quistty/6dofarm/README.md

# 6dofarm
Repository for my 6 DOF arm. 
Writeup coming soon
