quistty/6dofarm/Common parts/nema17.SLDASM

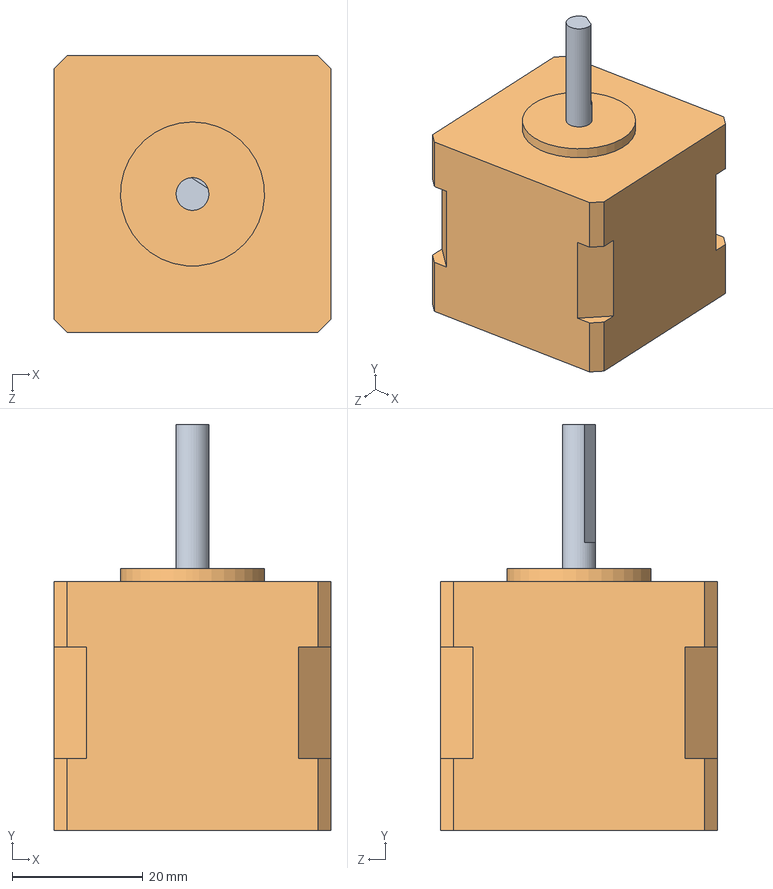
[picture p1: CAD file, 2026-08-21]
Common parts/nema17.SLDASM
42.3 x 62.0 x 42.3 mm
nema17Base
nema17Shaft
