quistty/6dofarm/Final Copy/Joint 4/Joint 4 Assembly.SLDASM

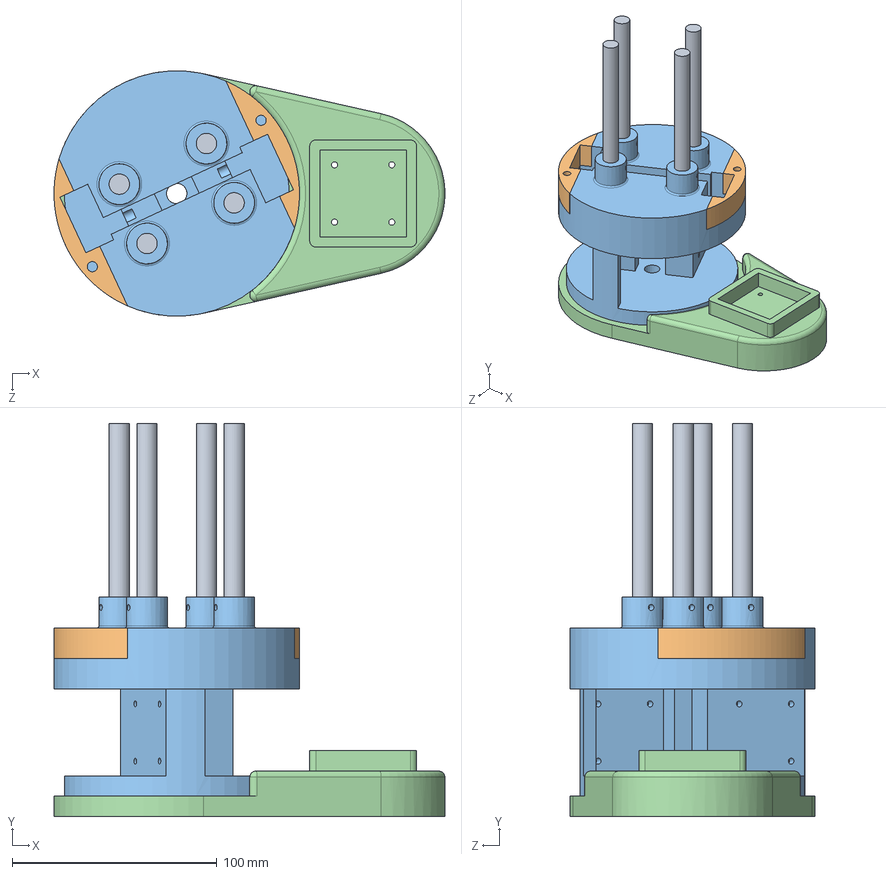
[picture p2: CAD file, 2026-08-21]
Final Copy/Joint 4/Joint 4 Assembly.SLDASM
191.1 x 192.3 x 120.0 mm
J4_Bottom_Motor_Housing
J4_Top_Motor_Housing
J4_Top_Motor_Housing_Bracket
J4_Connnecting_Rod x 4
