quistty/6dofarm/Joint 5-6/joint5and6MainBody.SLDPRT

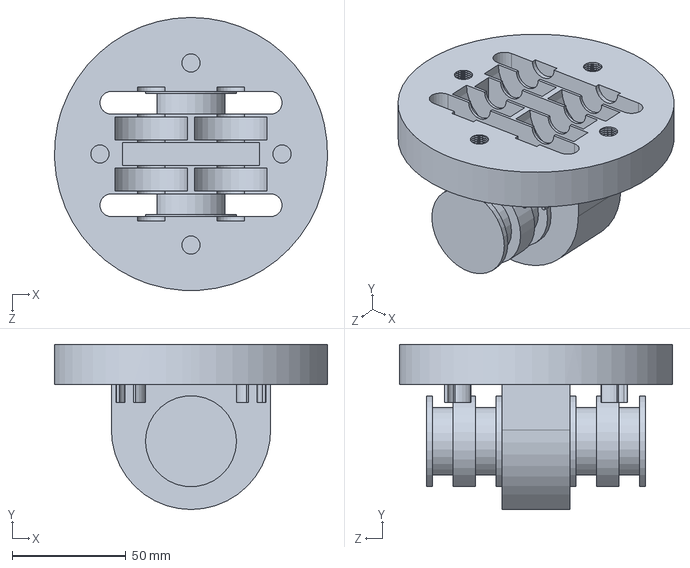
[picture p3: CAD file, 2026-06-25]
Joint 5-6/joint5and6MainBody.SLDPRT
119.9 x 72.5 x 120.0 mm
