quistty/6dofarm/Common parts/Gears/helicalGearCreator.SLDPRT

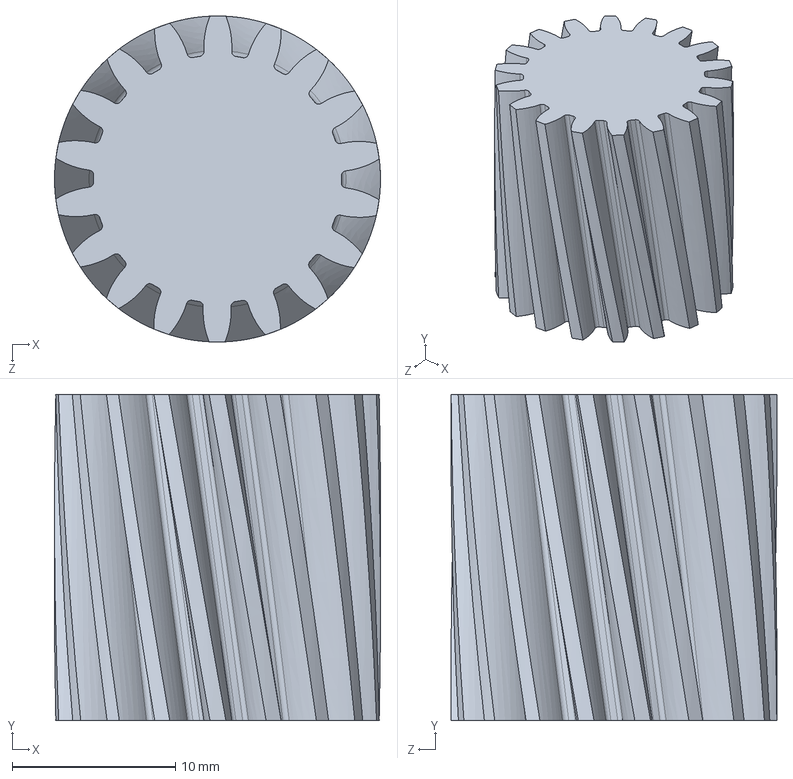
[picture p4: CAD file, 2026-07-15]
Common parts/Gears/helicalGearCreator.SLDPRT
20.0 x 20.0 x 20.0 mm
