quistty/6dofarm/Final Copy/Joint 2/J2_SunGear.SLDPRT

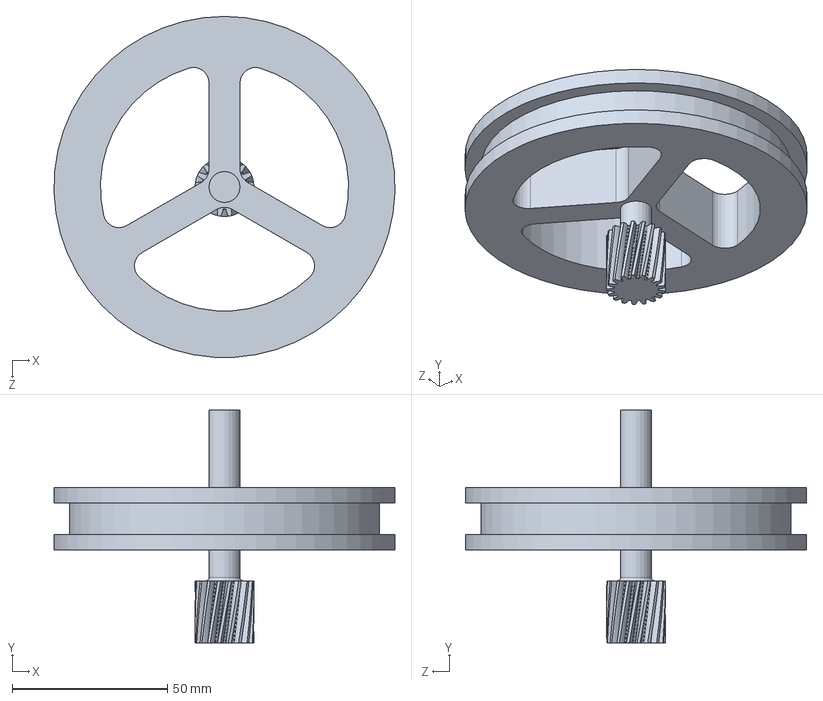
[picture p5: CAD file, 2026-08-21]
Final Copy/Joint 2/J2_SunGear.SLDPRT
109.9 x 75.0 x 110.0 mm
