quistty/6dofarm/Joint 1/BearingHolder.SLDPRT

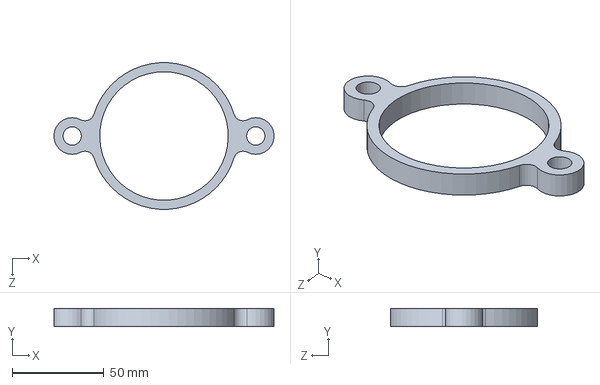
[picture p6: CAD file, 2026-08-21]
Joint 1/BearingHolder.SLDPRT
119.9 x 10.0 x 79.9 mm
