quistty/6dofarm/Joint 5-6/joint5and6BottomCover.SLDPRT

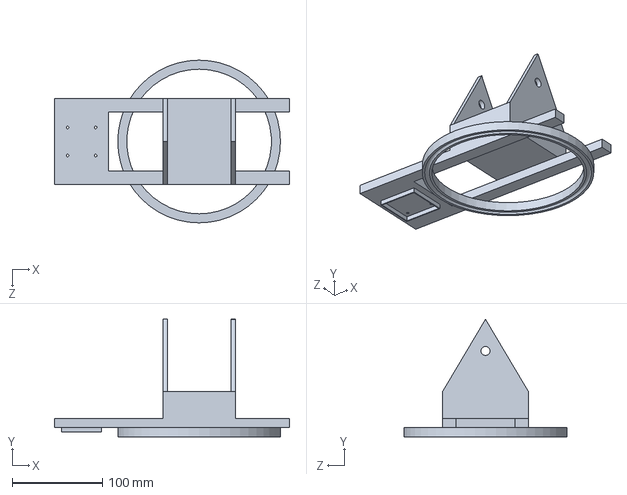
[picture p7: CAD file, 2026-07-15]
Joint 5-6/joint5and6BottomCover.SLDPRT
260.0 x 130.0 x 180.0 mm
