quistty/6dofarm/Prototypes/Part1.SLDPRT

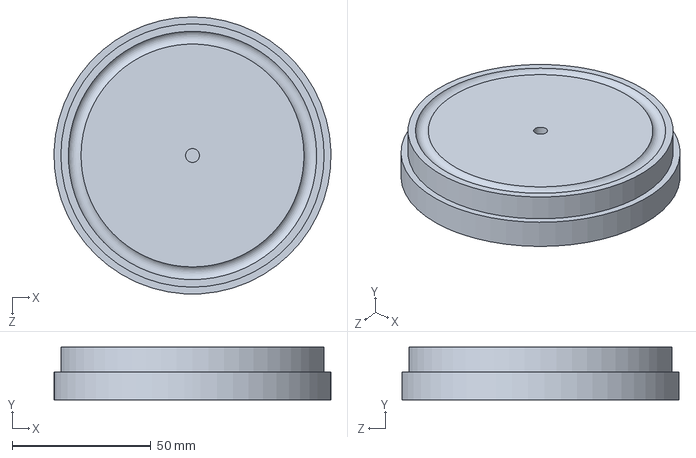
[picture p8: CAD file, 2026-08-05]
Prototypes/Part1.SLDPRT
100.0 x 19.0 x 100.0 mm
