quistty/6dofarm/Prototypes/Tolerances/40mm tolerance hole.SLDPRT

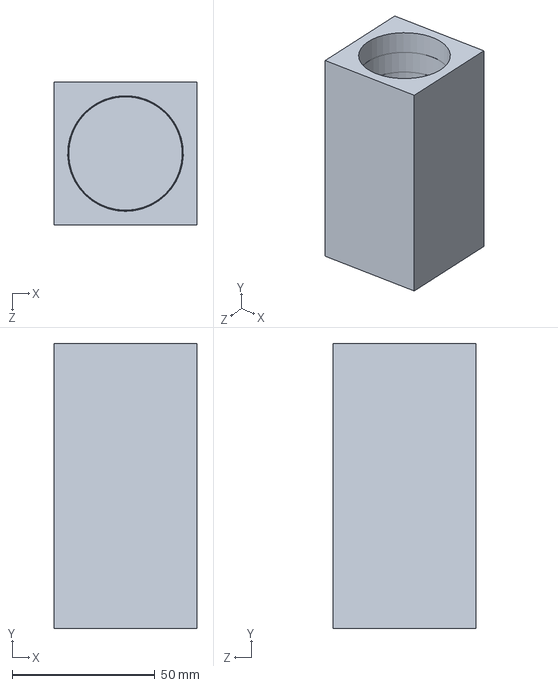
[picture p9: CAD file, 2026-08-18]
Prototypes/Tolerances/40mm tolerance hole.SLDPRT
50.0 x 100.0 x 50.0 mm
