quistty/6dofarm/Common parts/nema17Shaft.SLDPRT

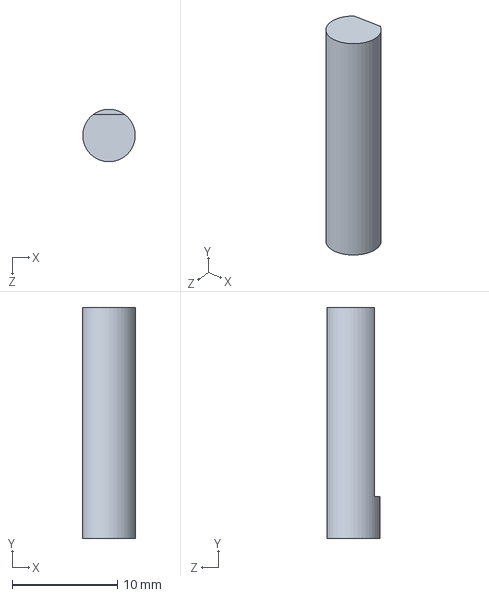
[picture p10: CAD file, 2026-08-13]
Common parts/nema17Shaft.SLDPRT
5.00 x 22.0 x 5.00 mm
