quistty/6dofarm/Final Copy/Joint 1/J1_helicalHousing.SLDPRT

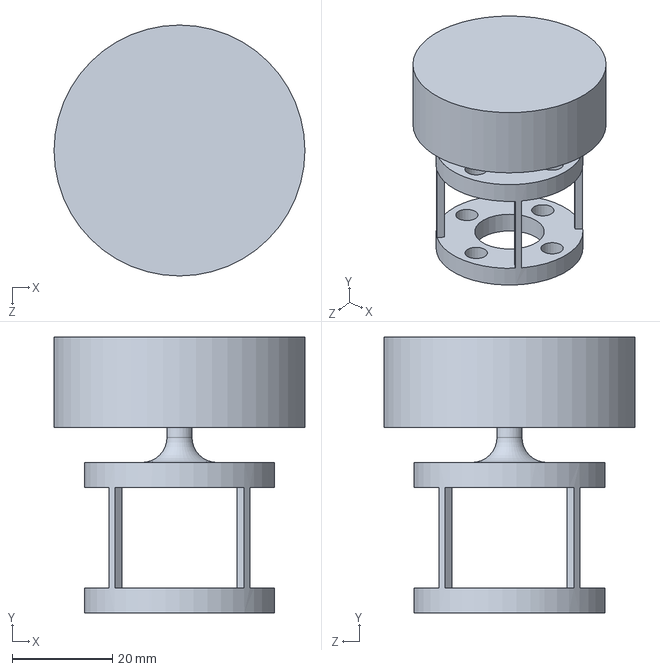
[picture p11: CAD file, 2026-08-21]
Final Copy/Joint 1/J1_helicalHousing.SLDPRT
50.0 x 55.0 x 50.0 mm
