quistty/6dofarm/Final Copy/Joint 4/J4_Bottom_Motor_Housing.SLDPRT

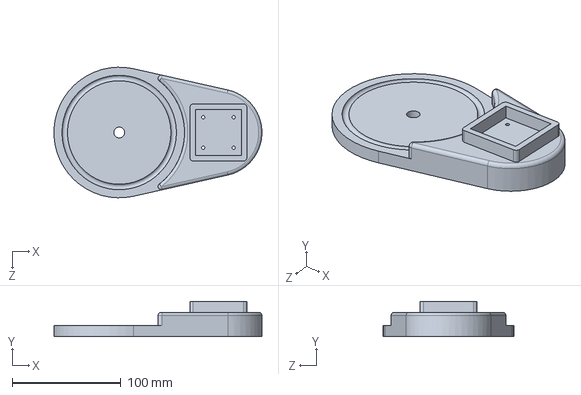
[picture p12: CAD file, 2026-08-13]
Final Copy/Joint 4/J4_Bottom_Motor_Housing.SLDPRT
191.0 x 32.3 x 120.0 mm
