quistty/6dofarm/Joint 1/Joint1Housing.SLDPRT

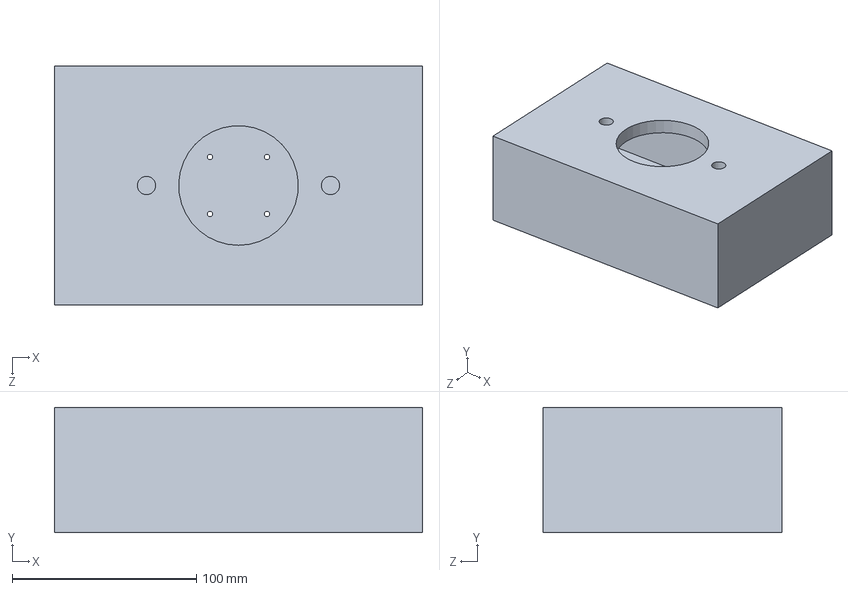
[picture p14: CAD file, 2026-08-21]
Joint 1/Joint1Housing.SLDPRT
200.0 x 68.0 x 130.0 mm
