quistty/6dofarm/Joint 2/Joint2RodHolder.SLDPRT

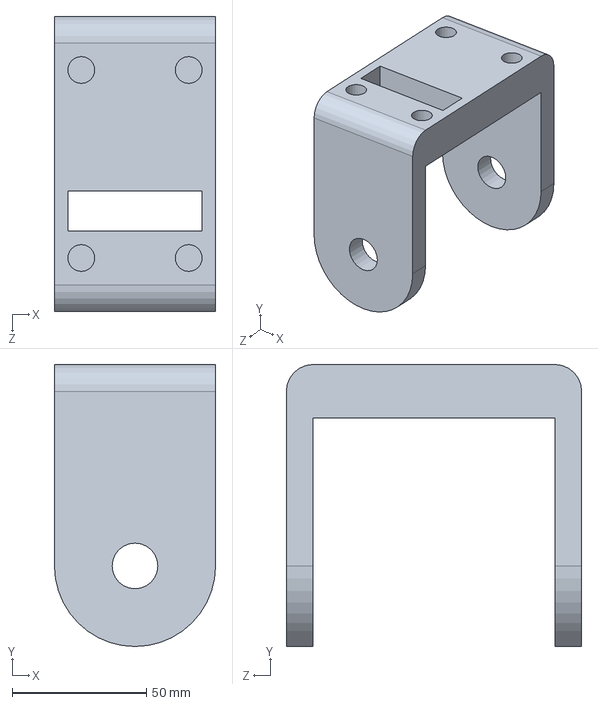
[picture p15: CAD file, 2026-08-21]
Joint 2/Joint2RodHolder.SLDPRT
60.0 x 105.0 x 110.0 mm
