quistty/6dofarm/Joint 3/HousingHelical.SLDPRT

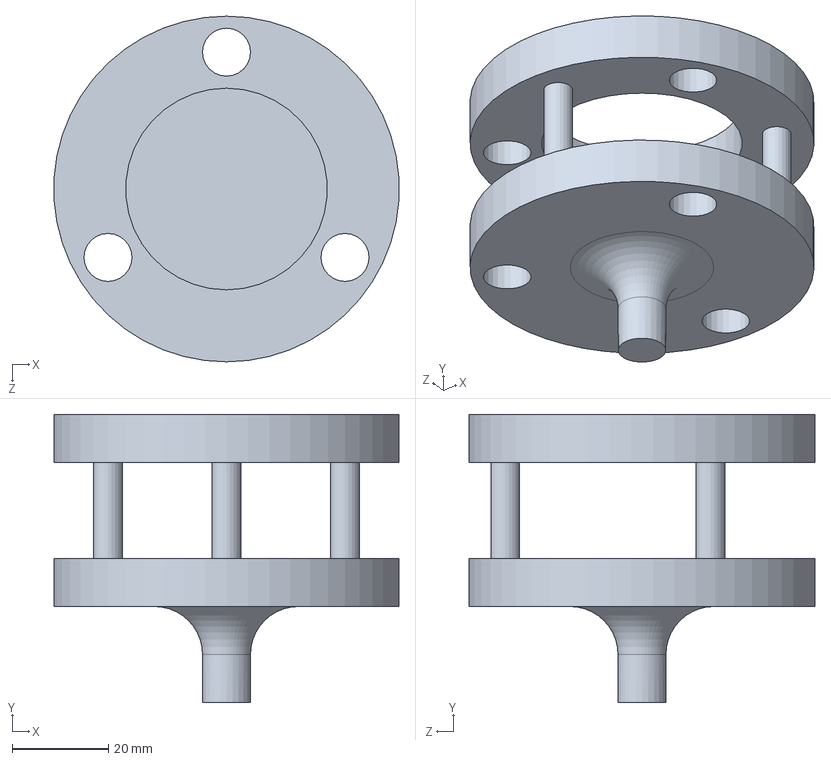
[picture p16: CAD file, 2026-07-15]
Joint 3/HousingHelical.SLDPRT
71.9 x 60.0 x 72.0 mm
