quistty/6dofarm/Prototypes/Tolerances/40mm nominal shaft.SLDPRT

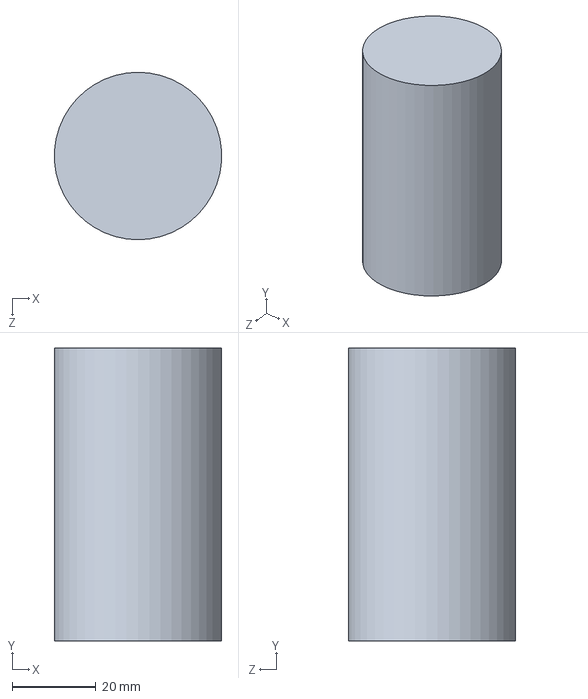
[picture p17: CAD file, 2026-08-18]
Prototypes/Tolerances/40mm nominal shaft.SLDPRT
39.9 x 70.0 x 40.0 mm
