quistty/6dofarm/Rough Assembly Parts/j2.SLDPRT

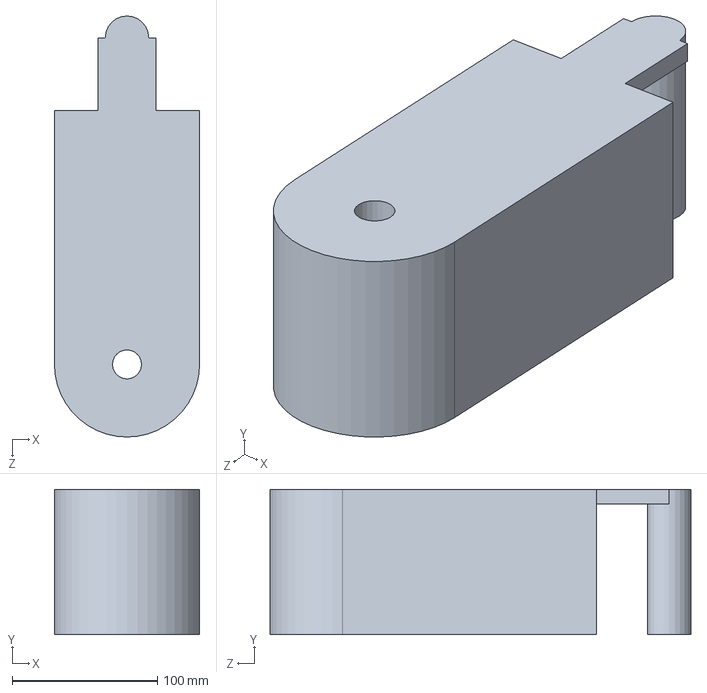
[picture p18: CAD file, 2026-06-13]
Rough Assembly Parts/j2.SLDPRT
100.0 x 100.0 x 290.0 mm
