quistty/6dofarm/Common parts/Gears/Gear1.SLDPRT

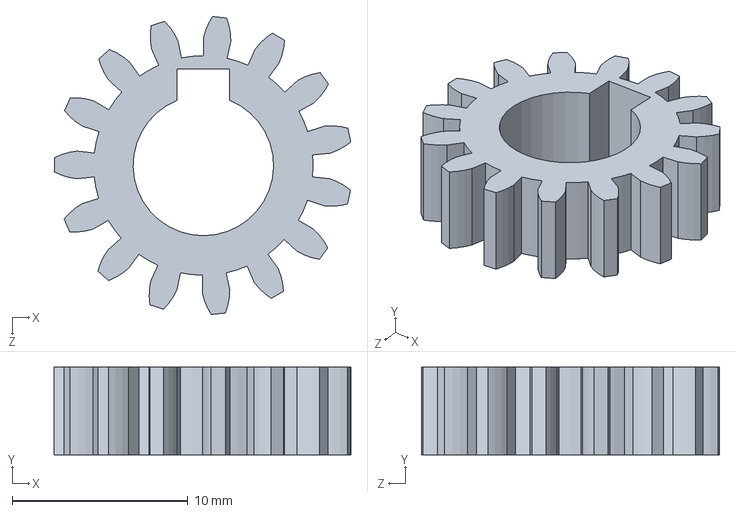
[picture p19: CAD file, 2026-07-01]
Common parts/Gears/Gear1.SLDPRT
16.9 x 5.00 x 17.0 mm
