quistty/6dofarm/Common parts/nema17Base.SLDPRT

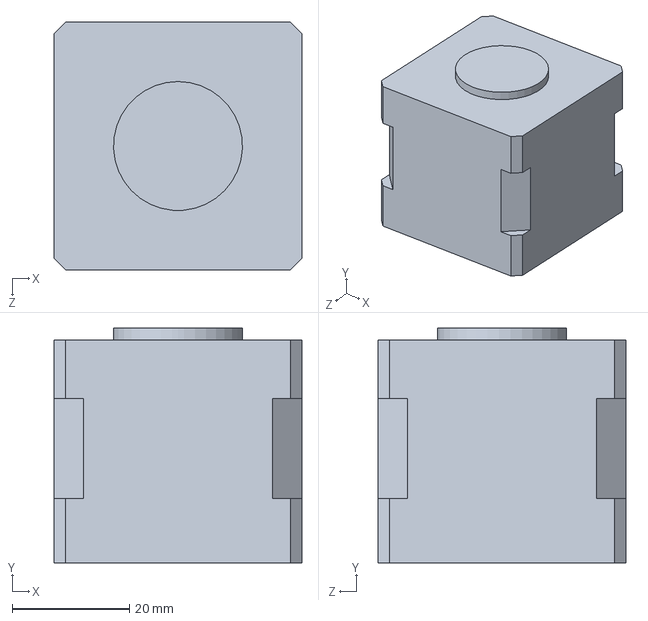
[picture p20: CAD file, 2026-08-13]
Common parts/nema17Base.SLDPRT
42.3 x 40.0 x 42.3 mm
