quistty/6dofarm/Final Copy/Joint 3/J3_Motor_Holder.SLDPRT

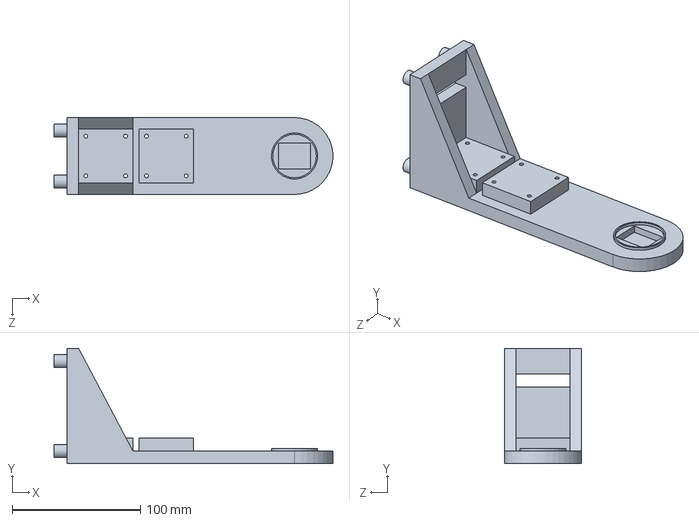
[picture p21: CAD file, 2026-08-21]
Final Copy/Joint 3/J3_Motor_Holder.SLDPRT
217.6 x 90.0 x 60.0 mm
