quistty/6dofarm/Final Copy/Joint 4/J4_Top_Motor_Housing.SLDPRT

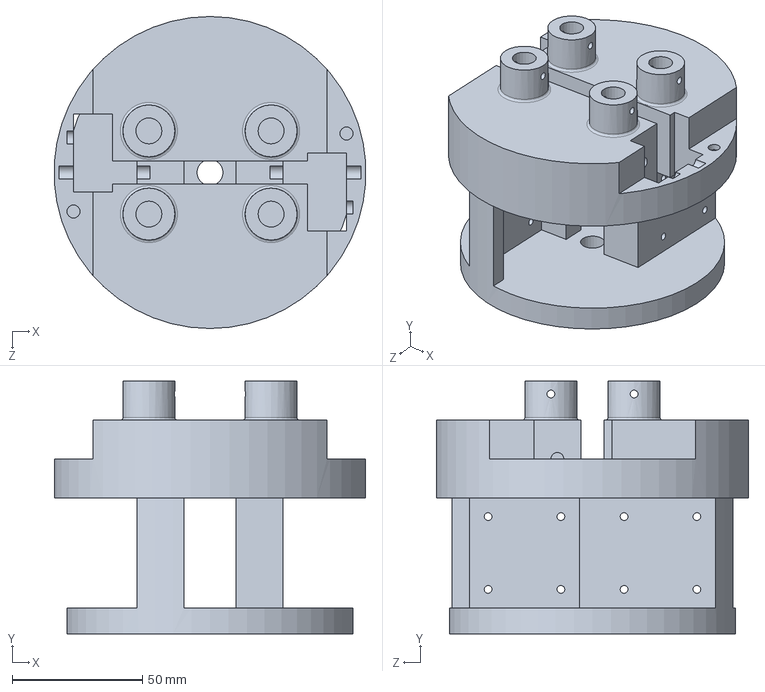
[picture p22: CAD file, 2026-08-12]
Final Copy/Joint 4/J4_Top_Motor_Housing.SLDPRT
119.8 x 97.3 x 120.0 mm
