quistty/6dofarm/Final Copy/Joint 5 and 6/J5-6_Dowel_Holder.SLDPRT

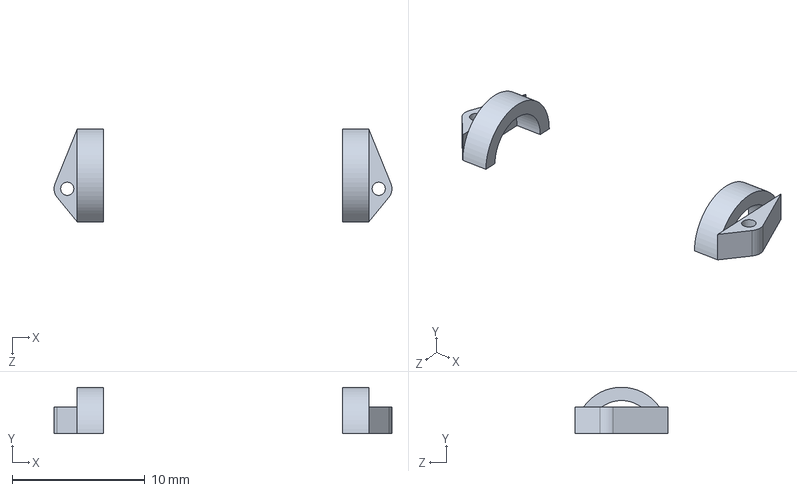
[picture p23: CAD file, 2026-08-13]
Final Copy/Joint 5 and 6/J5-6_Dowel_Holder.SLDPRT
25.5 x 3.50 x 7.00 mm
