quistty/6dofarm/Joint 2/GearRing.SLDPRT

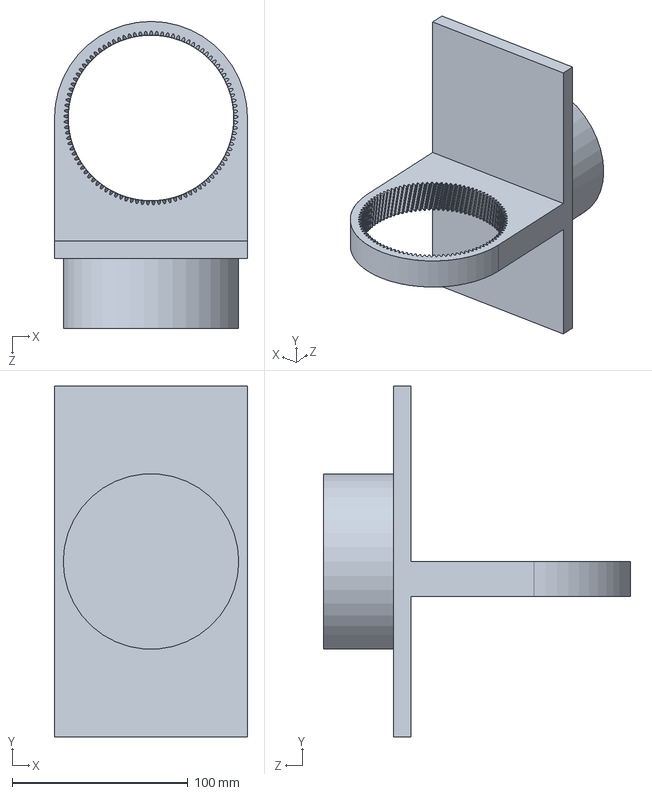
[picture p24: CAD file, 2026-07-15]
Joint 2/GearRing.SLDPRT
110.0 x 200.0 x 175.0 mm
