quistty/6dofarm/Joint 3/helicalSun2.3MF

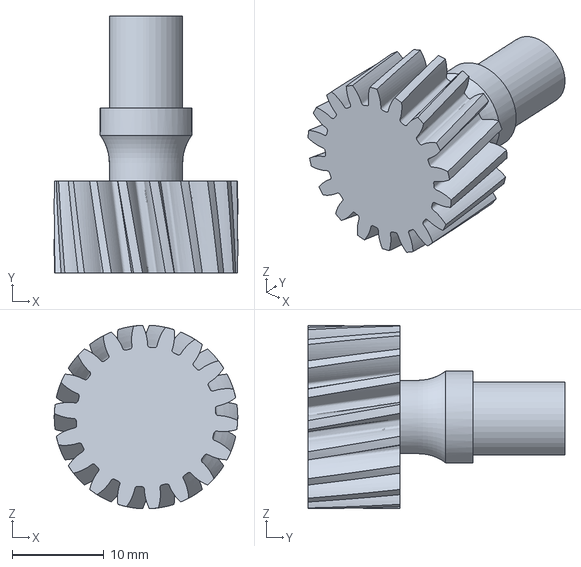
[picture p25: CAD file, 2026-07-13]
Joint 3/helicalSun2.3MF
20.0 x 28.0 x 20.0 mm
