quistty/6dofarm/Prototypes/Part5.SLDPRT

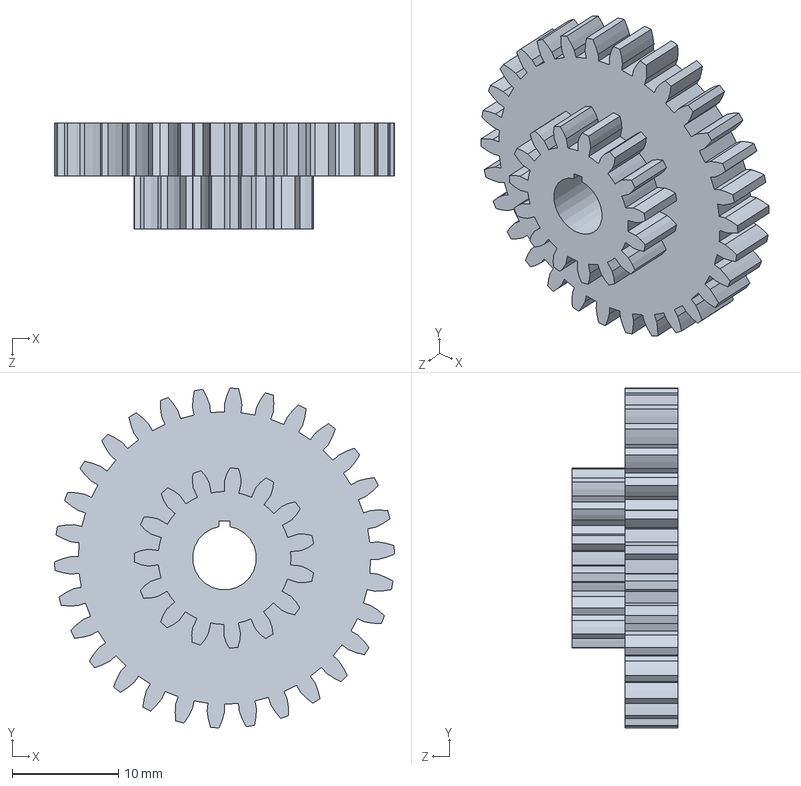
[picture p26: CAD file, 2026-07-13]
Prototypes/Part5.SLDPRT
32.0 x 32.0 x 10.0 mm
