quistty/6dofarm/Rough Assembly Parts/j6.SLDPRT

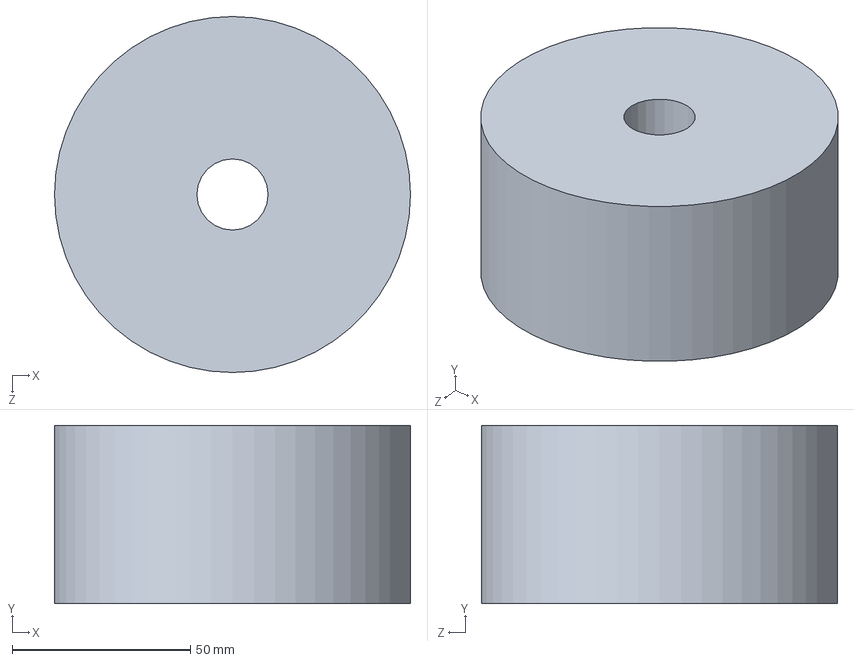
[picture p27: CAD file, 2026-06-13]
Rough Assembly Parts/j6.SLDPRT
100.0 x 50.0 x 100.0 mm
