quistty/6dofarm/Final Copy/Joint 1/J1_Motor_Housing.SLDPRT

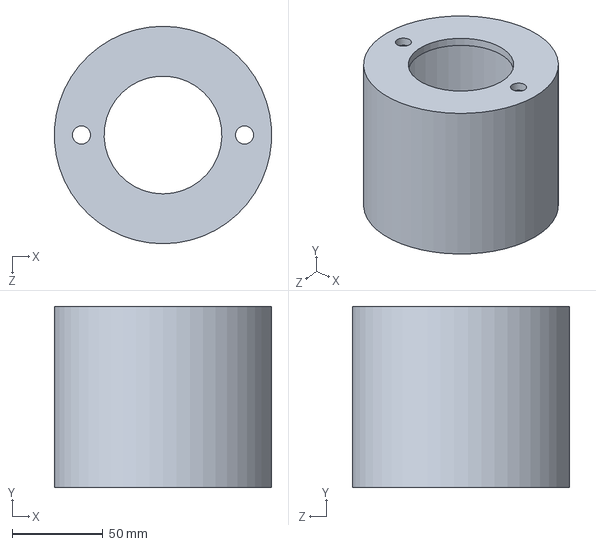
[picture p28: CAD file, 2026-08-21]
Final Copy/Joint 1/J1_Motor_Housing.SLDPRT
119.8 x 100.0 x 120.0 mm
