quistty/6dofarm/Final Copy/Joint 2/J2_Joint2RodHolder.SLDPRT

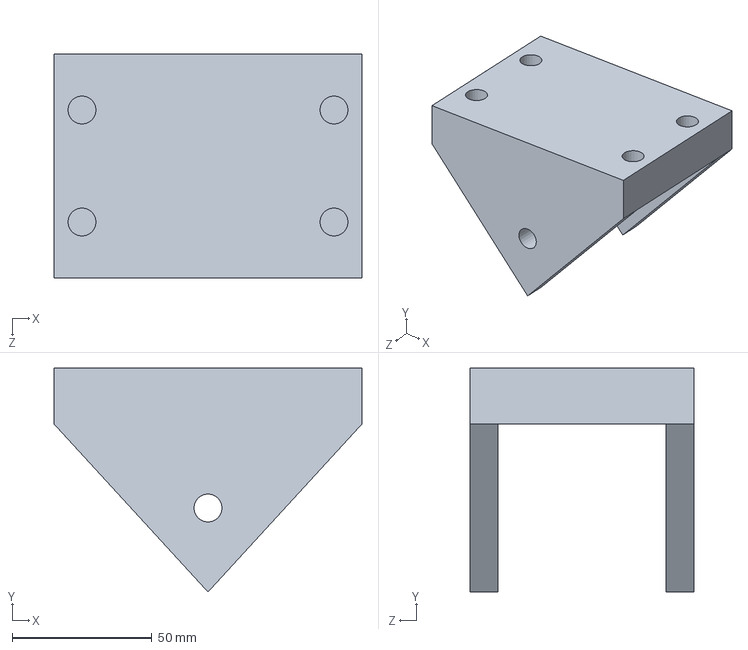
[picture p29: CAD file, 2026-08-21]
Final Copy/Joint 2/J2_Joint2RodHolder.SLDPRT
110.0 x 80.0 x 80.0 mm
