quistty/6dofarm/Final Copy/Joint 3/J3_Motor_Shaft_Key.SLDPRT

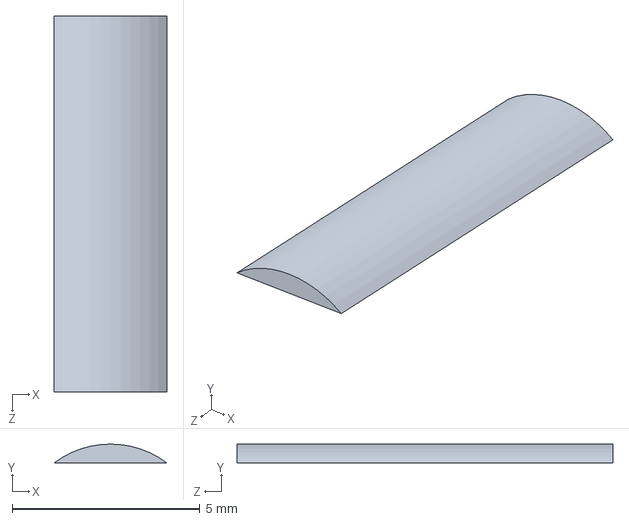
[picture p30: CAD file, 2026-08-13]
Final Copy/Joint 3/J3_Motor_Shaft_Key.SLDPRT
3.00 x 0.5 x 10.0 mm
