quistty/6dofarm/Final Copy/Joint 4/J4_Top_Motor_Housing_Bracket.SLDPRT

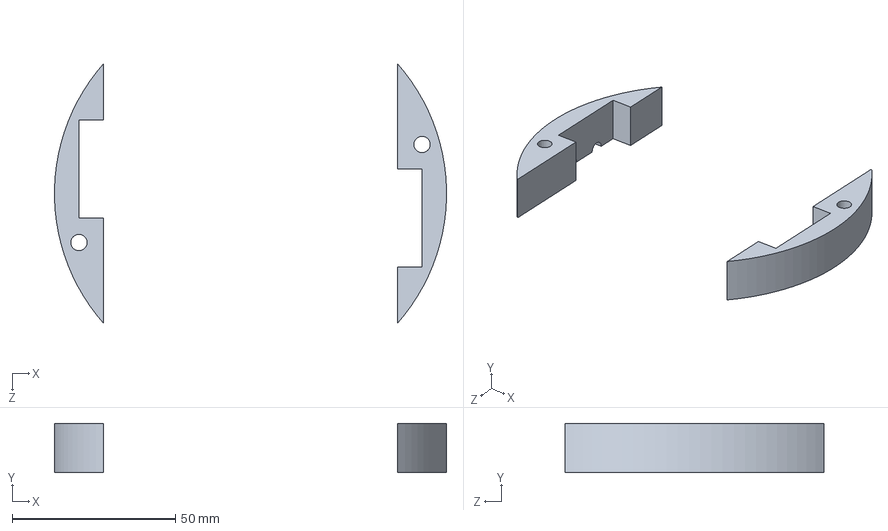
[picture p31: CAD file, 2026-08-11]
Final Copy/Joint 4/J4_Top_Motor_Housing_Bracket.SLDPRT
119.9 x 15.0 x 79.4 mm
