quistty/6dofarm/Final Copy/Joint 5 and 6/J5-6_Bottom_Flange.SLDPRT

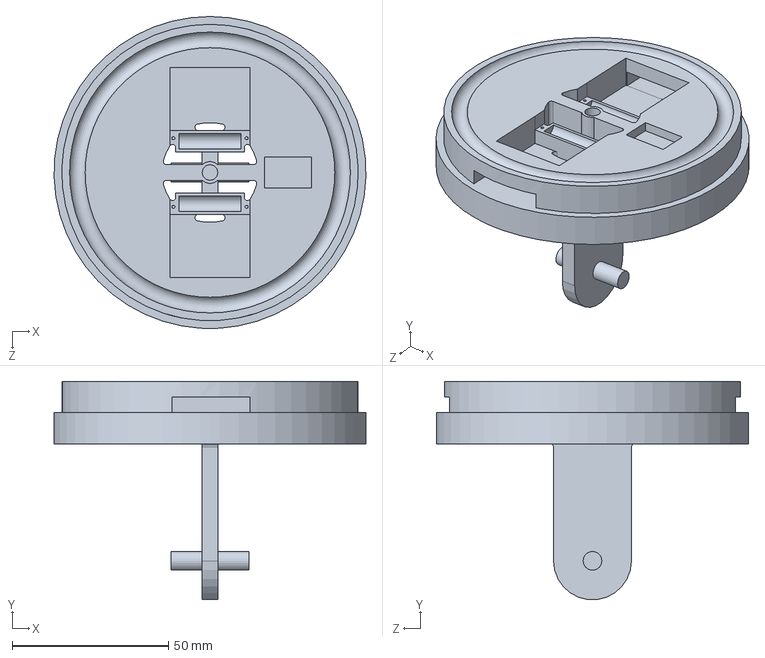
[picture p32: CAD file, 2026-08-13]
Final Copy/Joint 5 and 6/J5-6_Bottom_Flange.SLDPRT
100.0 x 69.9 x 100.0 mm
