quistty/6dofarm/Joint 2/SunGear.SLDPRT

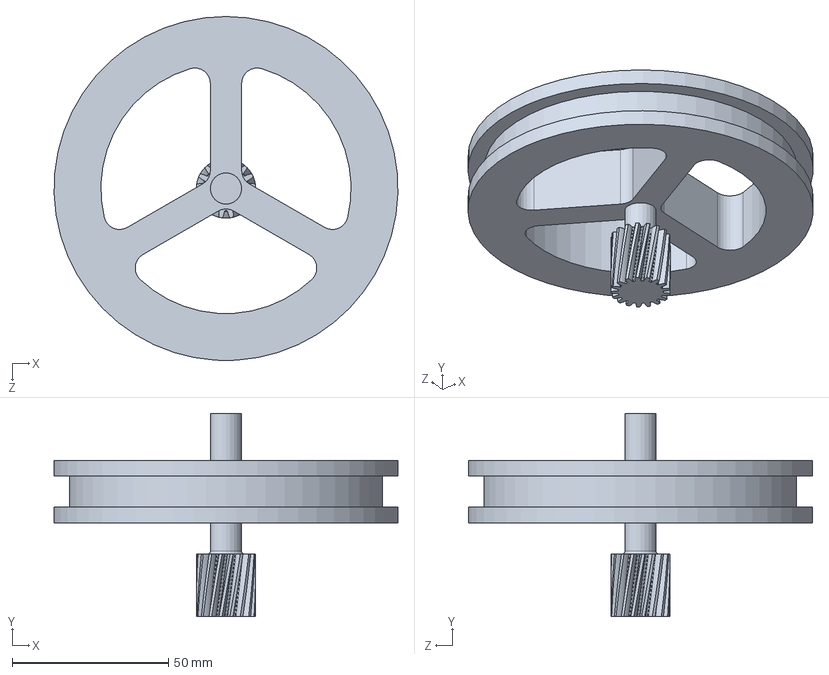
[picture p33: CAD file, 2026-07-15]
Joint 2/SunGear.SLDPRT
109.9 x 65.0 x 110.0 mm
