quistty/6dofarm/Joint 5-6/gearBottomCover.SLDPRT

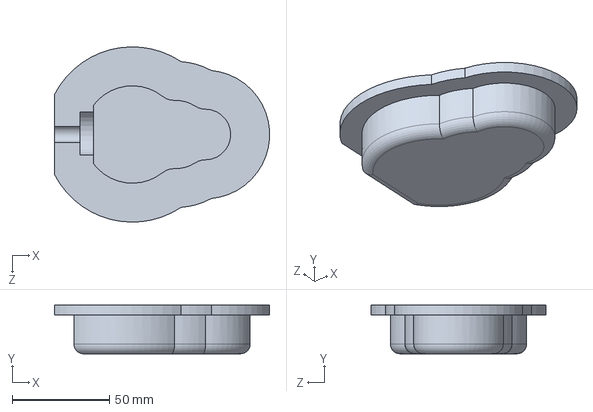
[picture p34: CAD file, 2026-07-13]
Joint 5-6/gearBottomCover.SLDPRT
110.4 x 25.0 x 90.0 mm
