quistty/6dofarm/Prototypes/Spiral Bevel gear Z1.3mf

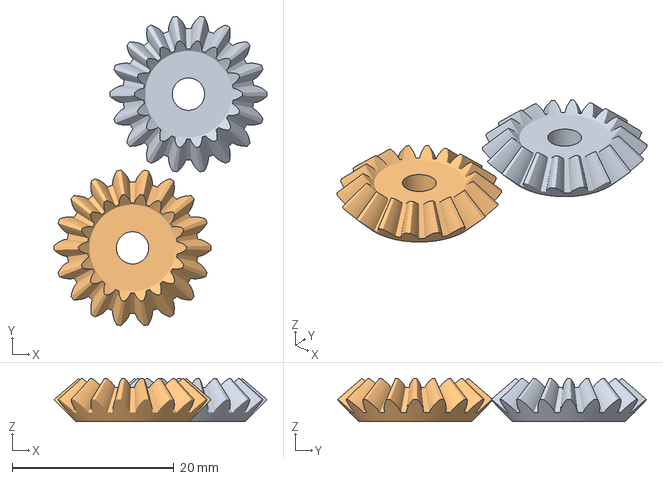
[picture p35: CAD file, 2026-07-01]
Prototypes/Spiral Bevel gear Z1.3mf
26.3 x 38.2 x 5.31 mm
Spiral Bevel gear Z1 x 2
