quistty/6dofarm/Rough Assembly Parts/j5.SLDPRT

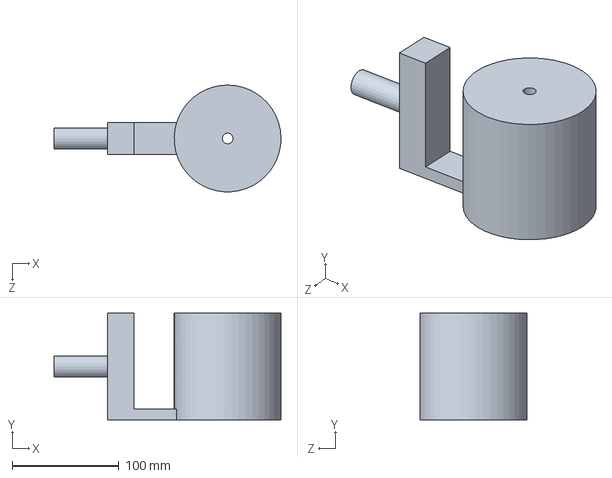
[picture p36: CAD file, 2026-06-13]
Rough Assembly Parts/j5.SLDPRT
212.5 x 100.0 x 100.0 mm
