quistty/6dofarm/Common parts/Gears/gearLocker.SLDPRT

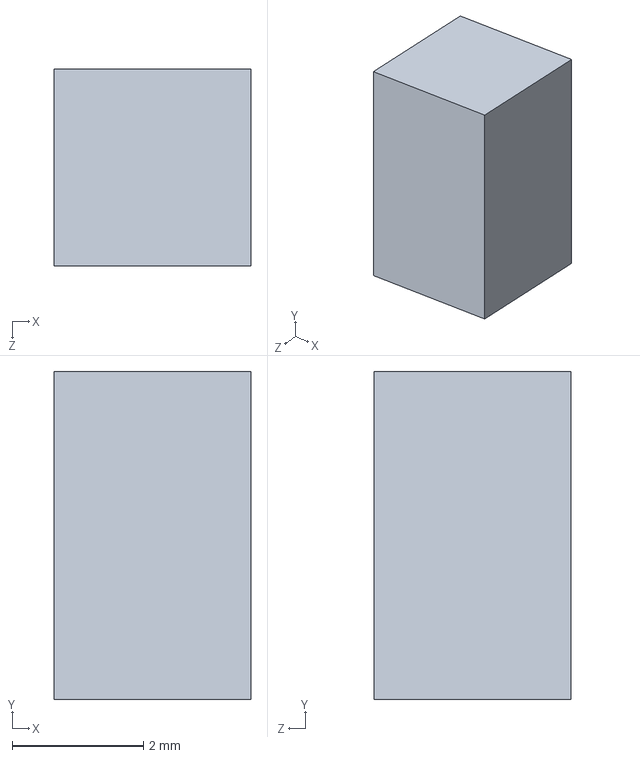
[picture p37: CAD file, 2026-07-01]
Common parts/Gears/gearLocker.SLDPRT
3.00 x 5.00 x 3.00 mm
