quistty/6dofarm/Final Copy/Joint 2/J2_HousingHelical.SLDPRT

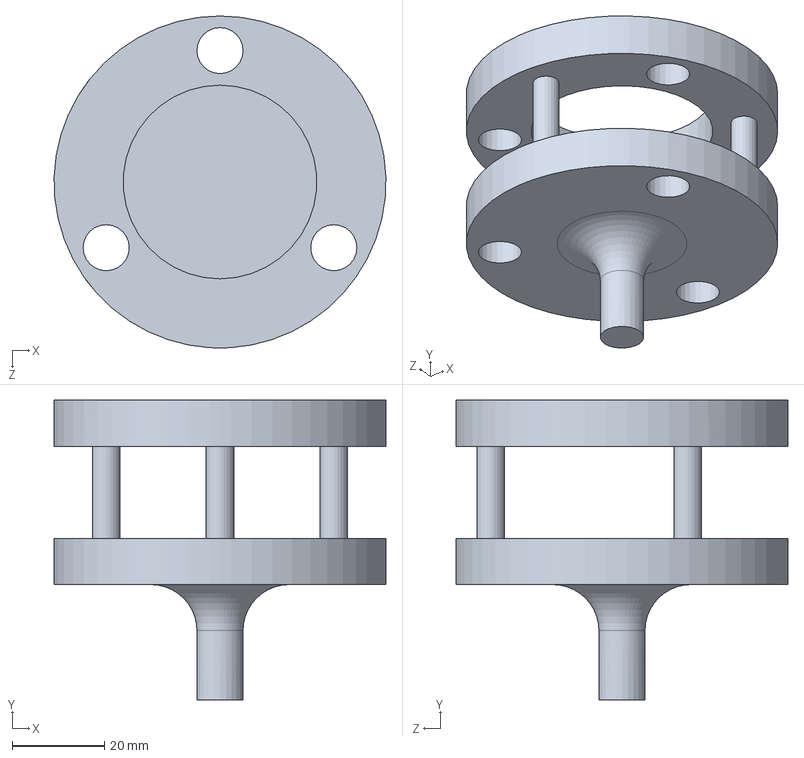
[picture p38: CAD file, 2026-08-21]
Final Copy/Joint 2/J2_HousingHelical.SLDPRT
72.0 x 65.0 x 72.0 mm
