quistty/6dofarm/Final Copy/Joint 3/J3_helicalSun.SLDPRT

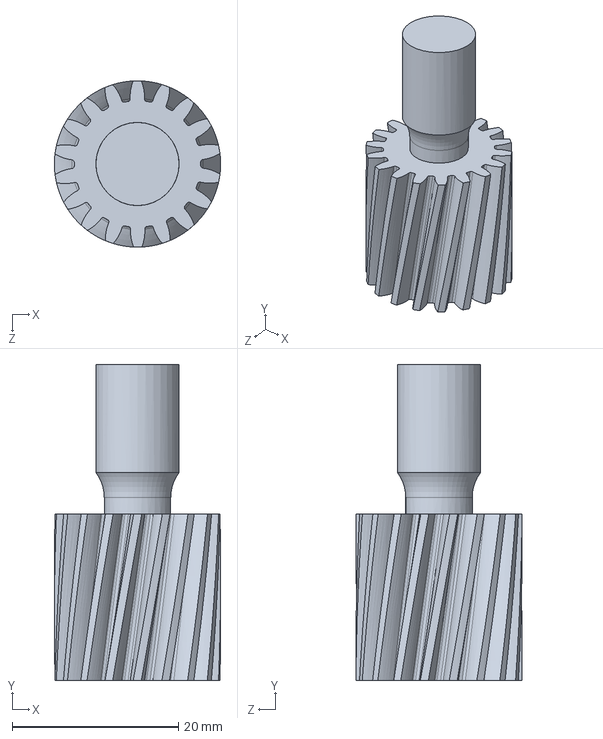
[picture p39: CAD file, 2026-08-13]
Final Copy/Joint 3/J3_helicalSun.SLDPRT
20.0 x 38.0 x 20.0 mm
