quistty/6dofarm/Final Copy/Joint 4/J4_Connnecting_Rod.SLDPRT

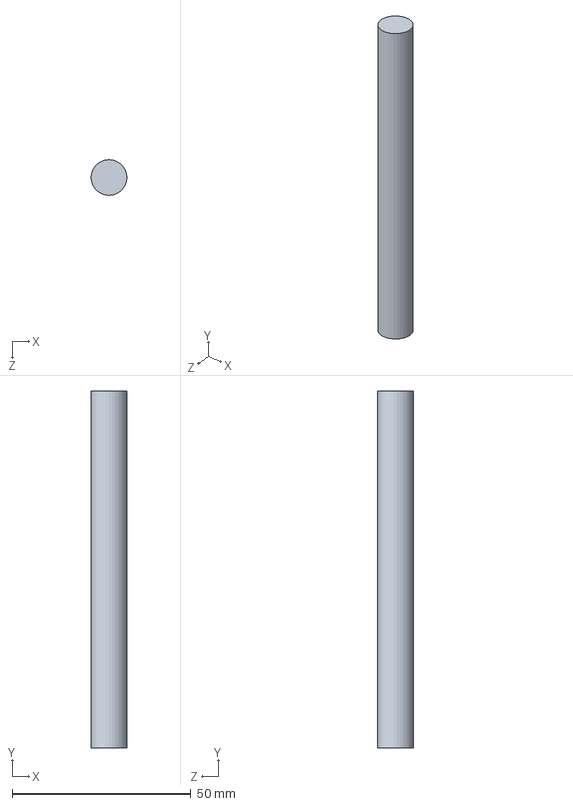
[picture p40: CAD file, 2026-08-08]
Final Copy/Joint 4/J4_Connnecting_Rod.SLDPRT
9.96 x 100.0 x 10.0 mm
