quistty/6dofarm/Final Copy/Joint 5 and 6/J5-6_Bottom_Flange_Inner_Belt_Holder.SLDPRT

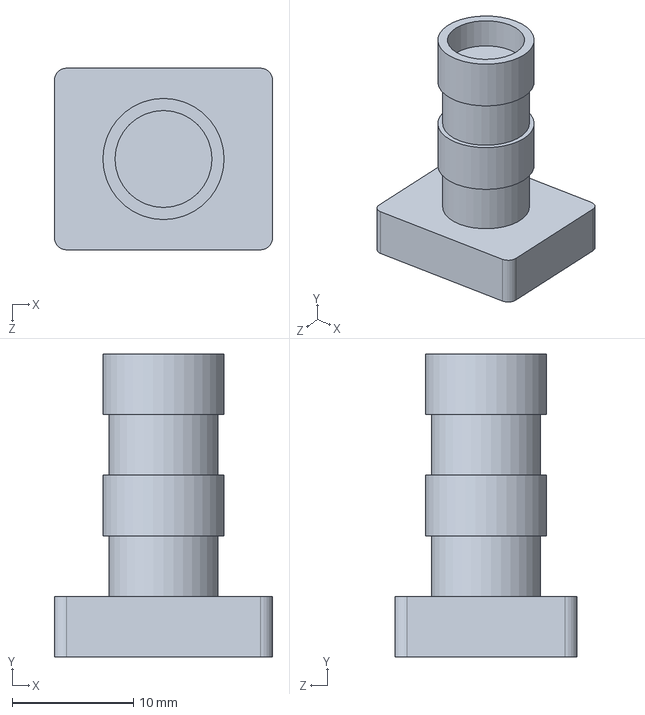
[picture p41: CAD file, 2026-08-11]
Final Copy/Joint 5 and 6/J5-6_Bottom_Flange_Inner_Belt_Holder.SLDPRT
18.0 x 25.0 x 15.0 mm
