quistty/6dofarm/Joint 2/Joint2Rods.SLDPRT

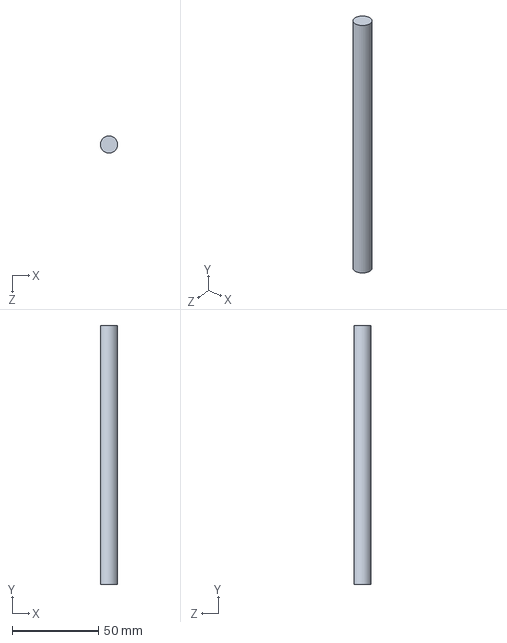
[picture p42: CAD file, 2026-07-15]
Joint 2/Joint2Rods.SLDPRT
9.99 x 150.0 x 10.0 mm
