quistty/6dofarm/Joint 3/helicalPlanet.3MF

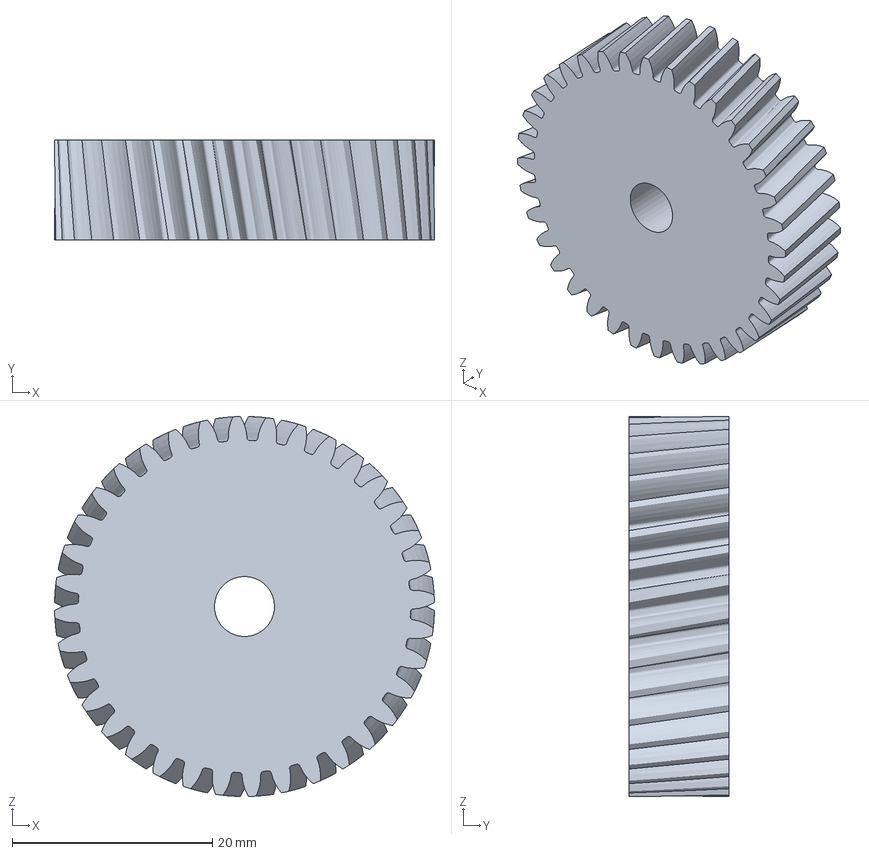
[picture p43: CAD file, 2026-07-13]
Joint 3/helicalPlanet.3MF
38.0 x 10.0 x 38.0 mm
