quistty/6dofarm/Joint 5-6/joint4BracketBase.SLDPRT

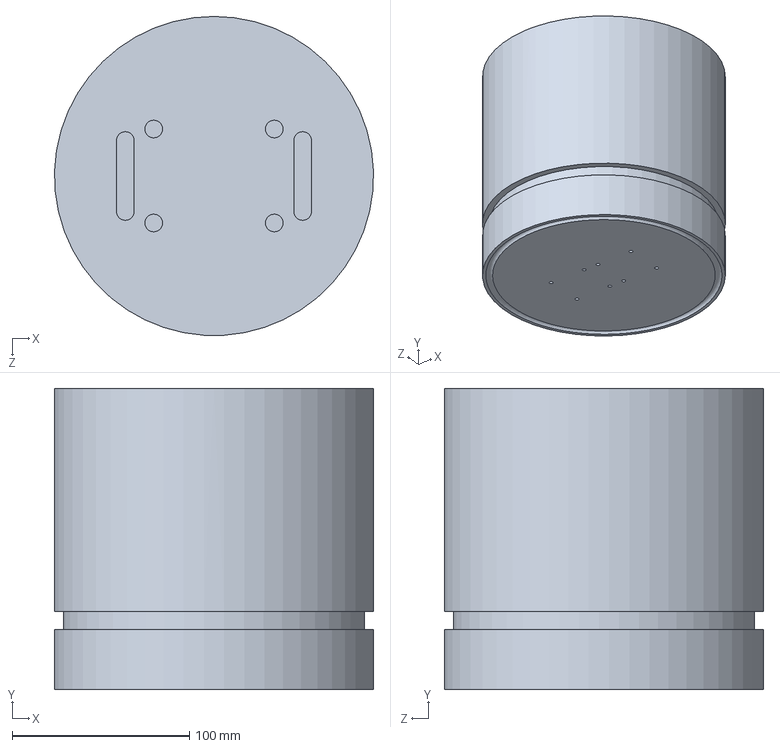
[picture p44: CAD file, 2026-07-03]
Joint 5-6/joint4BracketBase.SLDPRT
179.9 x 170.0 x 180.0 mm
