quistty/6dofarm/Prototypes/combinedGears.3MF

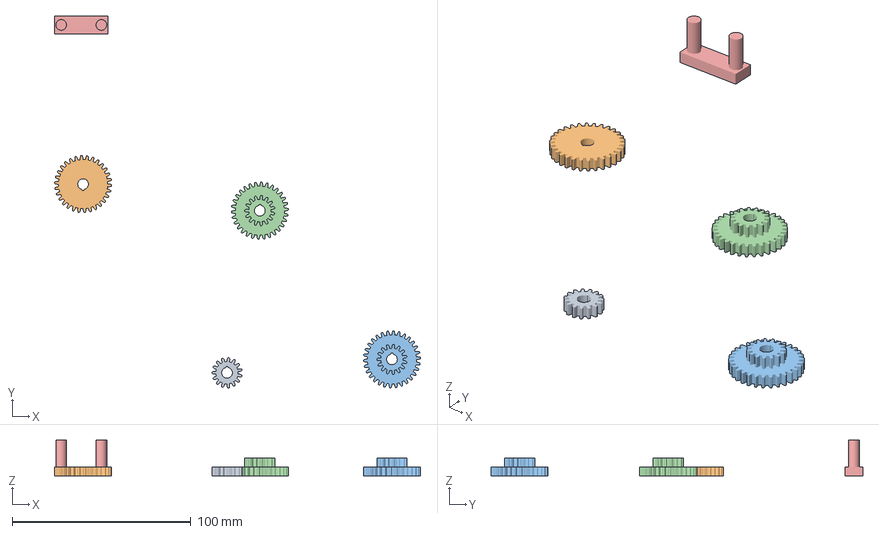
[picture p45: CAD file, 2026-06-29]
Prototypes/combinedGears.3MF
204.7 x 208.0 x 20.0 mm
gear1
gear2
combinedGears x 2
gearTester
