quistty/6dofarm/Rough Assembly Parts/j4.SLDPRT

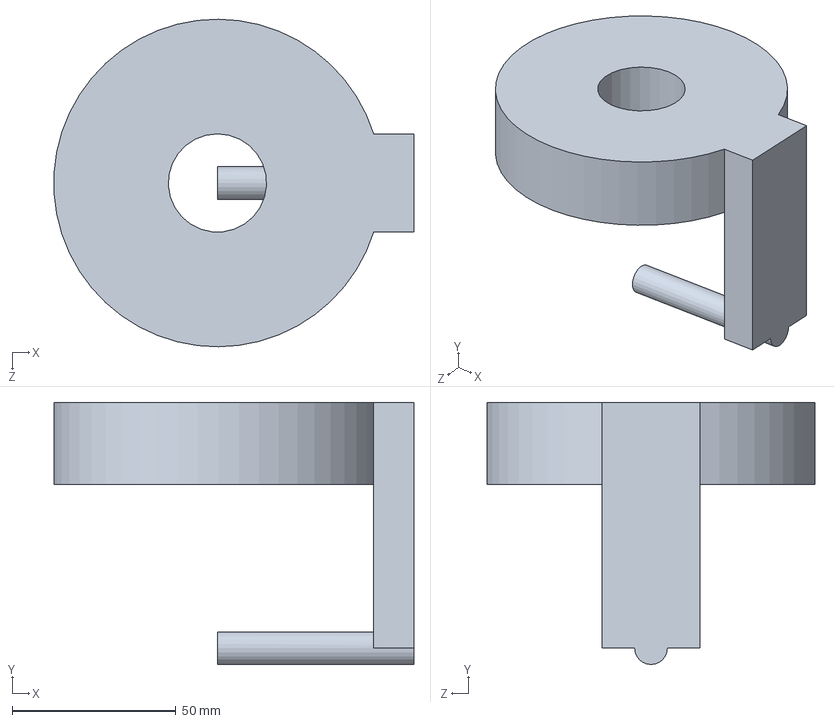
[picture p46: CAD file, 2026-06-13]
Rough Assembly Parts/j4.SLDPRT
109.9 x 80.0 x 100.0 mm
