quistty/6dofarm/Common parts/gearKey.SLDPRT

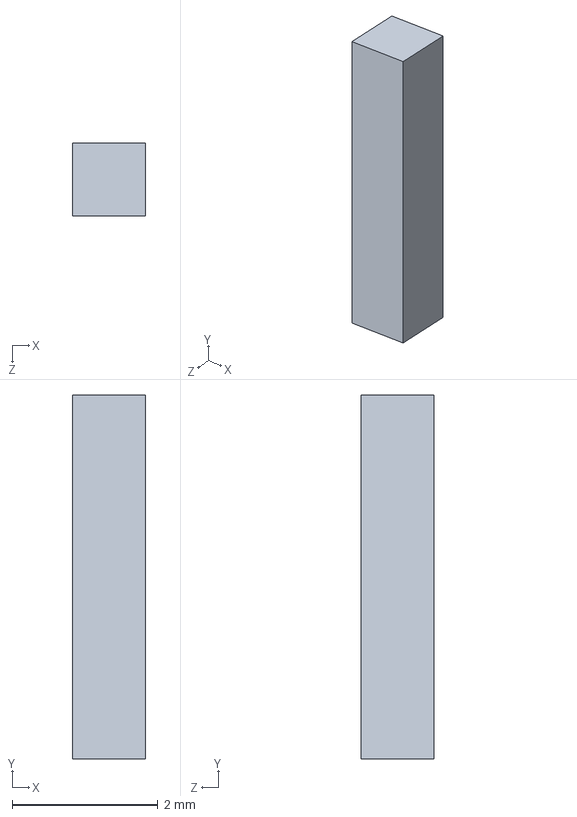
[picture p47: CAD file, 2026-06-25]
Common parts/gearKey.SLDPRT
1.00 x 5.00 x 1.00 mm
