quistty/6dofarm/Final Copy/Joint 1/J1_helicalHousingPin.SLDPRT

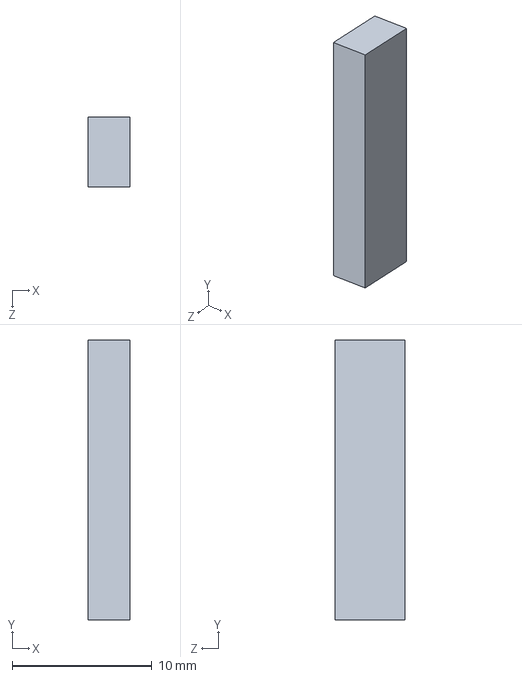
[picture p48: CAD file, 2026-08-21]
Final Copy/Joint 1/J1_helicalHousingPin.SLDPRT
3.00 x 20.0 x 5.00 mm
