quistty/6dofarm/Final Copy/Joint 2/J2_GearRing.SLDPRT

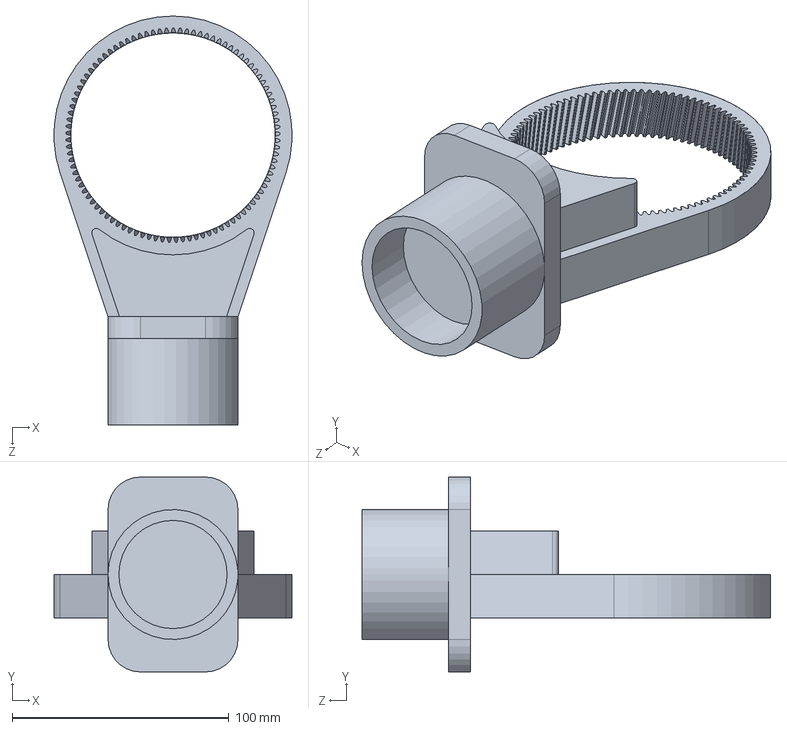
[picture p49: CAD file, 2026-08-21]
Final Copy/Joint 2/J2_GearRing.SLDPRT
109.9 x 90.0 x 188.8 mm
