quistty/6dofarm/Final Copy/Joint 3/J3_Motor_Shaft.SLDPRT

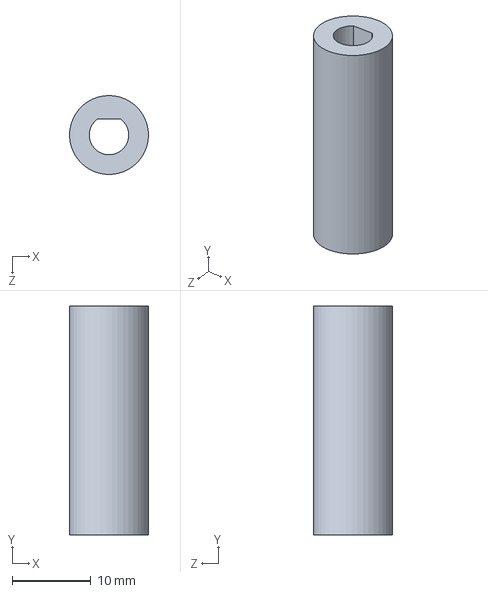
[picture p50: CAD file, 2026-08-13]
Final Copy/Joint 3/J3_Motor_Shaft.SLDPRT
9.99 x 29.0 x 10.0 mm
