quistty/6dofarm/Final Copy/Joint 5 and 6/J5-6_Flange_Holder.SLDPRT

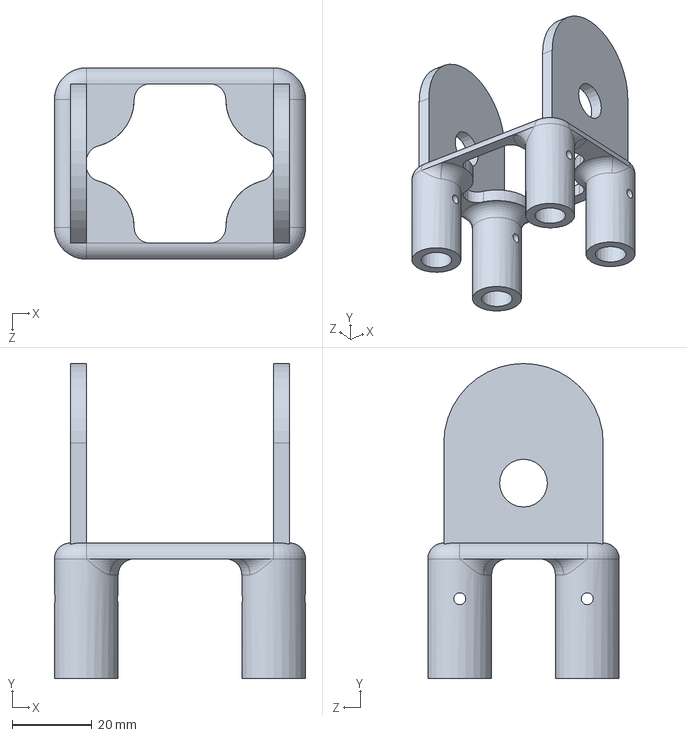
[picture p51: CAD file, 2026-08-11]
Final Copy/Joint 5 and 6/J5-6_Flange_Holder.SLDPRT
63.0 x 79.0 x 48.0 mm
