quistty/6dofarm/Joint 3/helicalRing.3mf

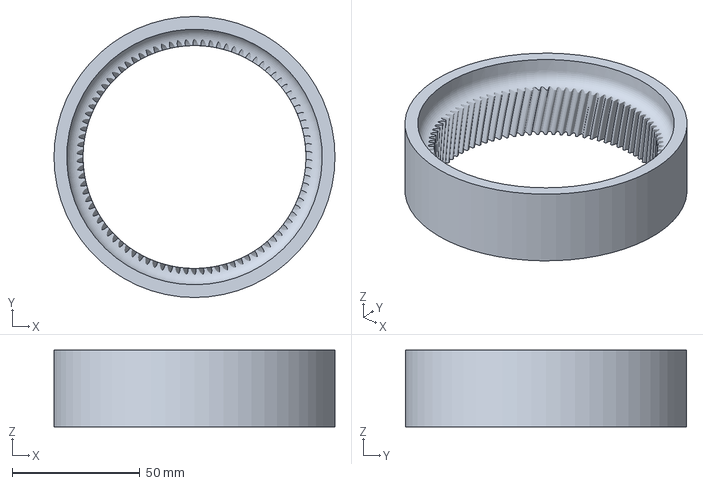
[picture p52: CAD file, 2026-07-13]
Joint 3/helicalRing.3mf
110.0 x 110.0 x 30.0 mm
