quistty/6dofarm/Joint 5-6/bevelGearLock.SLDPRT

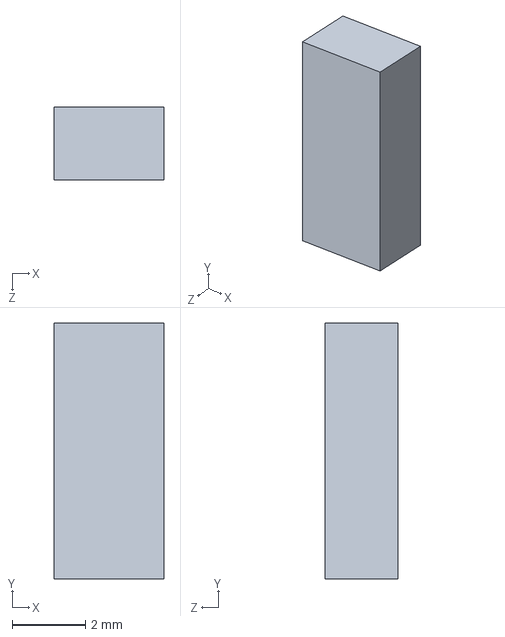
[picture p53: CAD file, 2026-07-01]
Joint 5-6/bevelGearLock.SLDPRT
3.00 x 7.00 x 2.00 mm
