quistty/6dofarm/Prototypes/gearTEster.SLDPRT

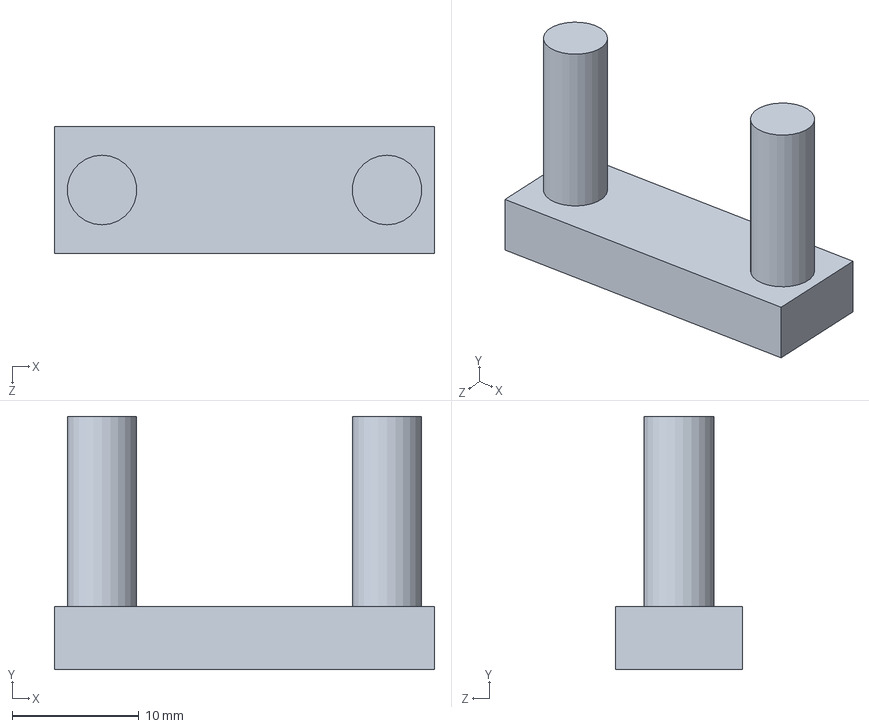
[picture p54: CAD file, 2026-06-29]
Prototypes/gearTEster.SLDPRT
30.0 x 20.0 x 10.0 mm
