quistty/6dofarm/Rough Assembly Parts/J1.SLDPRT

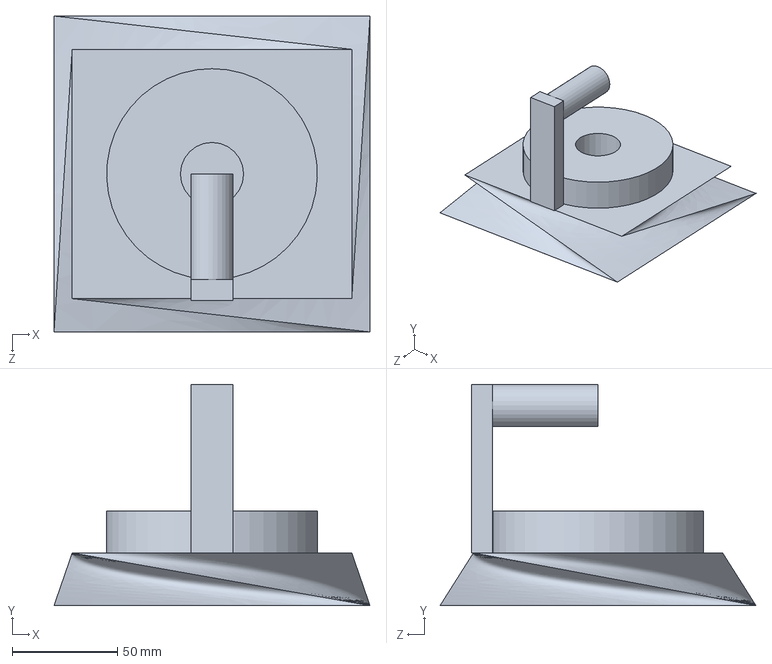
[picture p55: CAD file, 2026-06-13]
Rough Assembly Parts/J1.SLDPRT
150.0 x 105.0 x 150.0 mm
