quistty/6dofarm/Common parts/gearCreator.SLDPRT

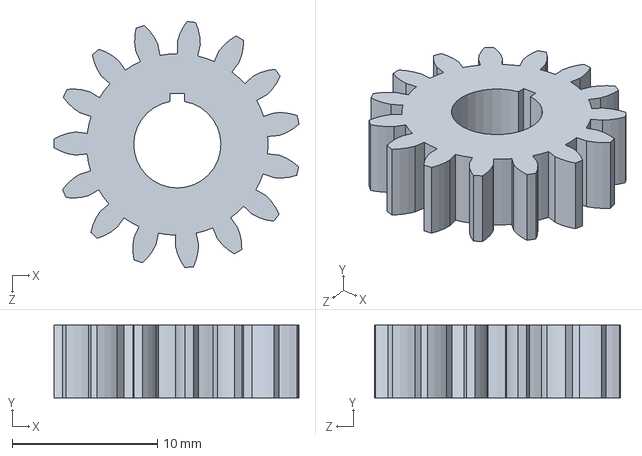
[picture p56: CAD file, 2026-06-25]
Common parts/gearCreator.SLDPRT
16.9 x 5.00 x 17.0 mm
