quistty/6dofarm/Common parts/Gears/gear3.SLDPRT

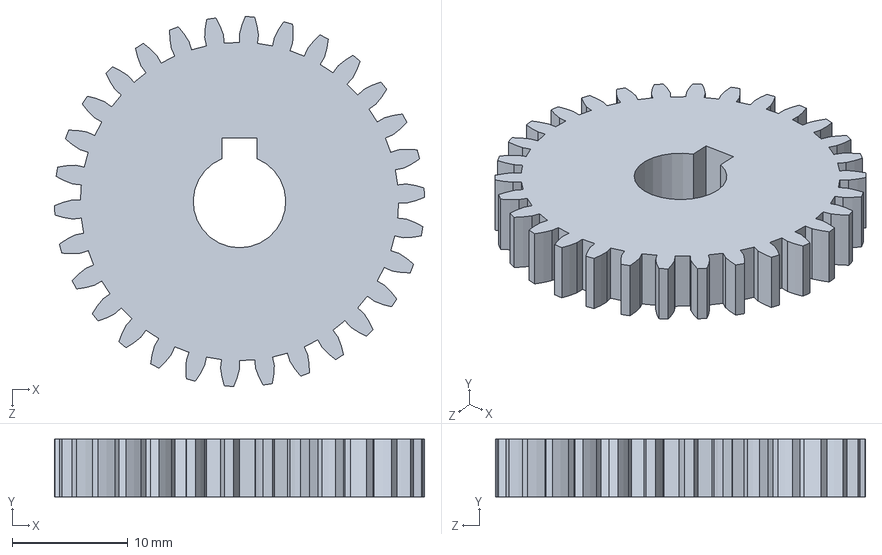
[picture p57: CAD file, 2026-07-01]
Common parts/Gears/gear3.SLDPRT
32.0 x 5.00 x 32.0 mm
