quistty/6dofarm/Final Copy/Joint 1/J1_Bottom_Housing.SLDPRT

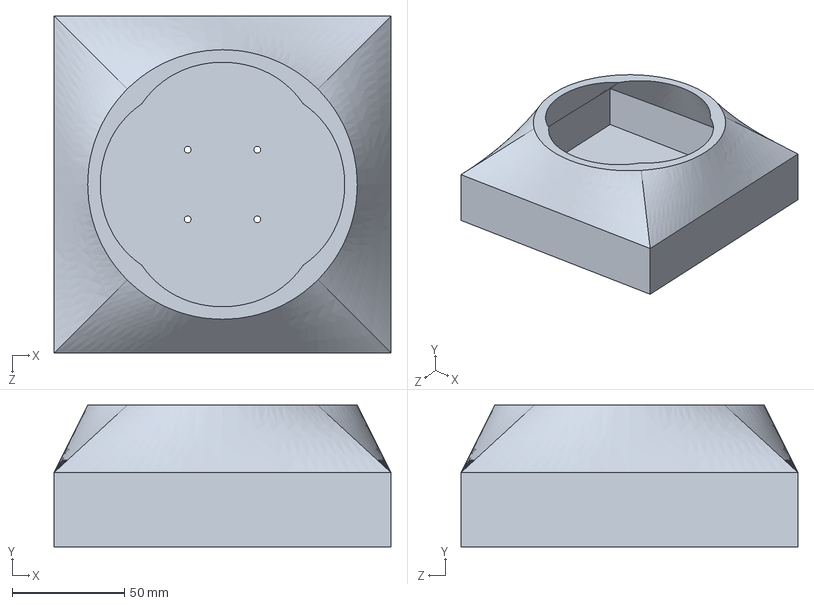
[picture p58: CAD file, 2026-08-21]
Final Copy/Joint 1/J1_Bottom_Housing.SLDPRT
150.0 x 63.0 x 150.0 mm
