quistty/6dofarm/Final Copy/Joint 2/J2_PlanetGear.SLDPRT

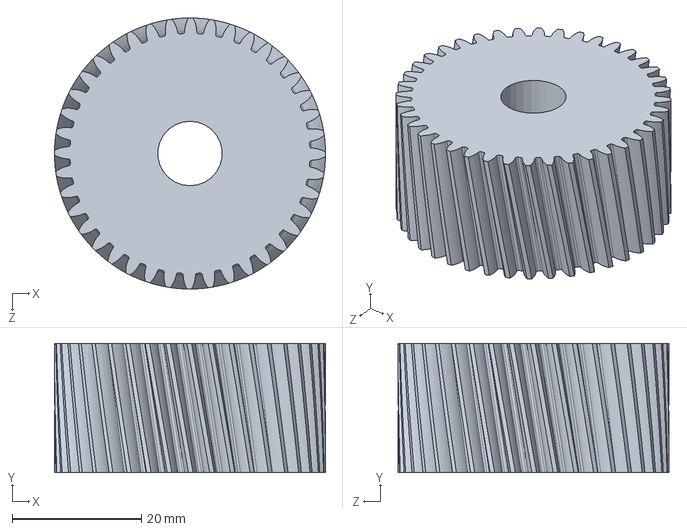
[picture p59: CAD file, 2026-07-15]
Final Copy/Joint 2/J2_PlanetGear.SLDPRT
42.0 x 20.0 x 42.0 mm
