quistty/6dofarm/Final Copy/Joint 3/J3_helicalHousing.SLDPRT

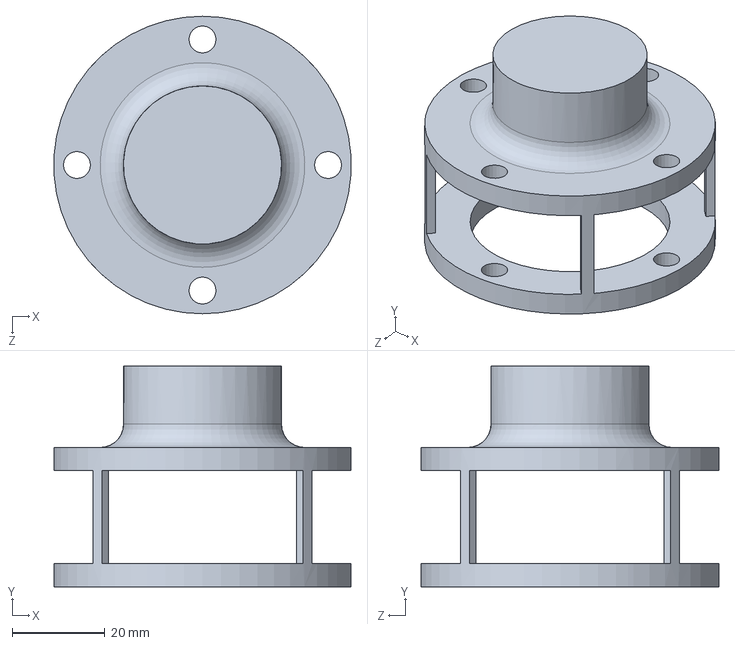
[picture p60: CAD file, 2026-08-13]
Final Copy/Joint 3/J3_helicalHousing.SLDPRT
63.9 x 47.5 x 64.0 mm
