quistty/6dofarm/Joint 3/helicalHousingPin.3MF

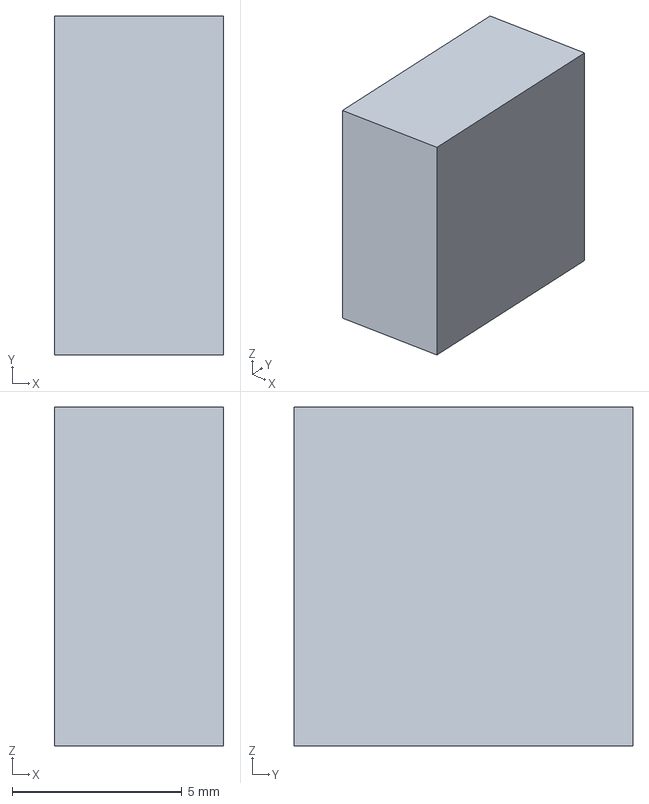
[picture p61: CAD file, 2026-07-13]
Joint 3/helicalHousingPin.3MF
5.00 x 10.0 x 10.0 mm
