quistty/6dofarm/Joint 5-6/joint5BevelShaft.SLDPRT

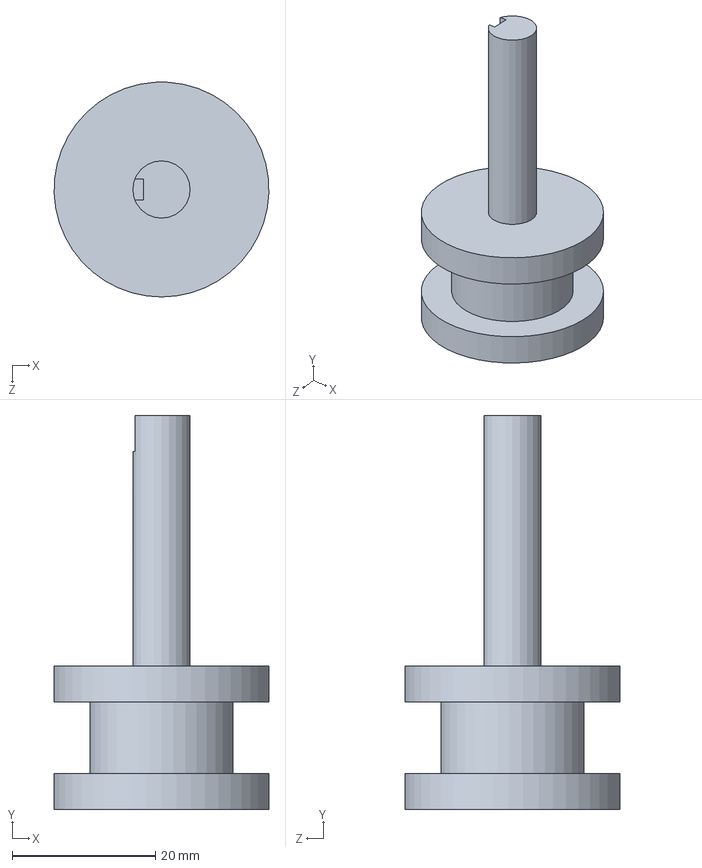
[picture p62: CAD file, 2026-07-01]
Joint 5-6/joint5BevelShaft.SLDPRT
30.0 x 55.0 x 30.0 mm
