quistty/6dofarm/Rough Assembly Parts/j3.SLDPRT

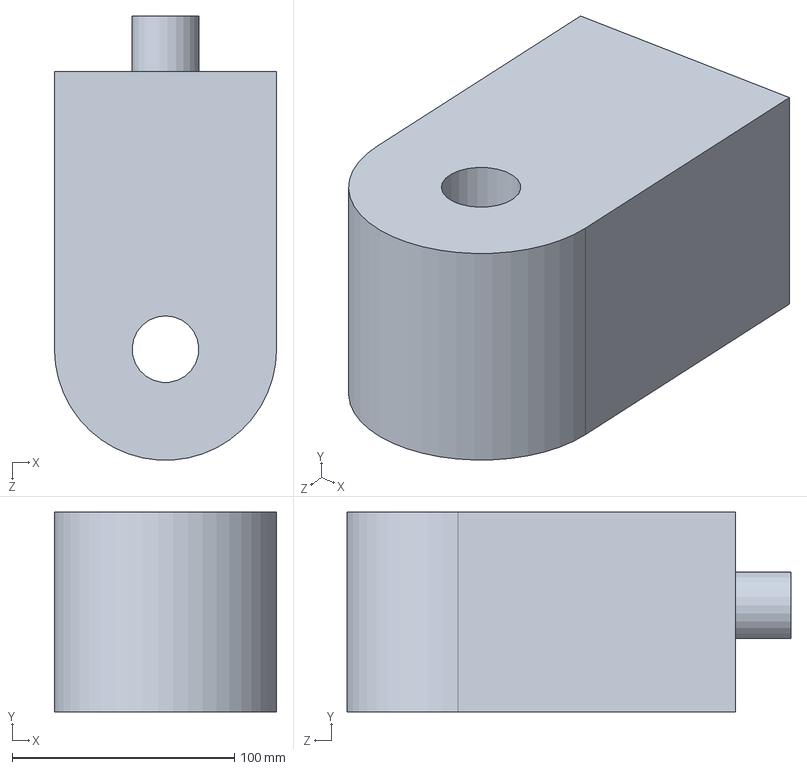
[picture p63: CAD file, 2026-06-13]
Rough Assembly Parts/j3.SLDPRT
100.0 x 90.0 x 199.9 mm
