quistty/6dofarm/Final Copy/Joint 1/J1_helicalSun.SLDPRT

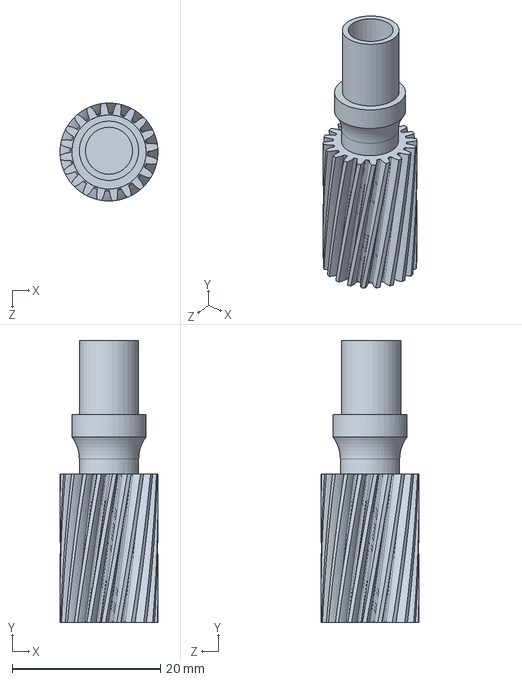
[picture p64: CAD file, 2026-08-21]
Final Copy/Joint 1/J1_helicalSun.SLDPRT
13.2 x 38.0 x 13.2 mm
