quistty/6dofarm/Final Copy/Joint 3/J3_Bearing_Bracket.SLDPRT

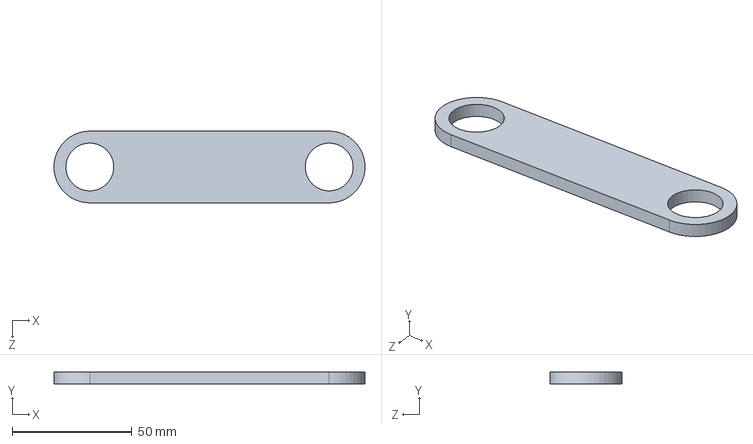
[picture p65: CAD file, 2026-08-13]
Final Copy/Joint 3/J3_Bearing_Bracket.SLDPRT
129.9 x 5.00 x 30.0 mm
