quistty/6dofarm/Joint 3/helicalPin.SLDPRT

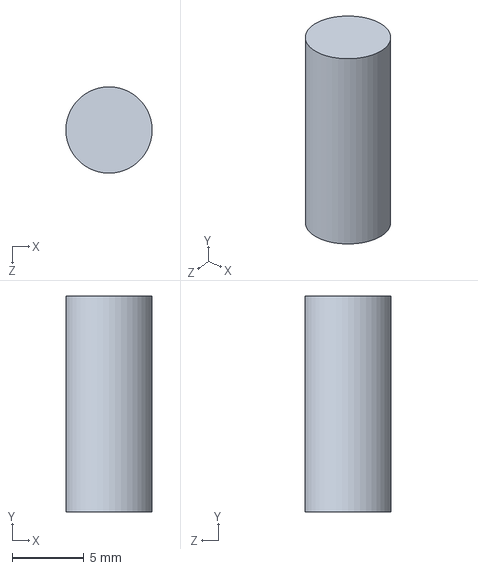
[picture p66: CAD file, 2026-07-13]
Joint 3/helicalPin.SLDPRT
6.00 x 15.0 x 6.00 mm
