quistty/6dofarm/Joint 5-6/joint5MotorShaft.SLDPRT

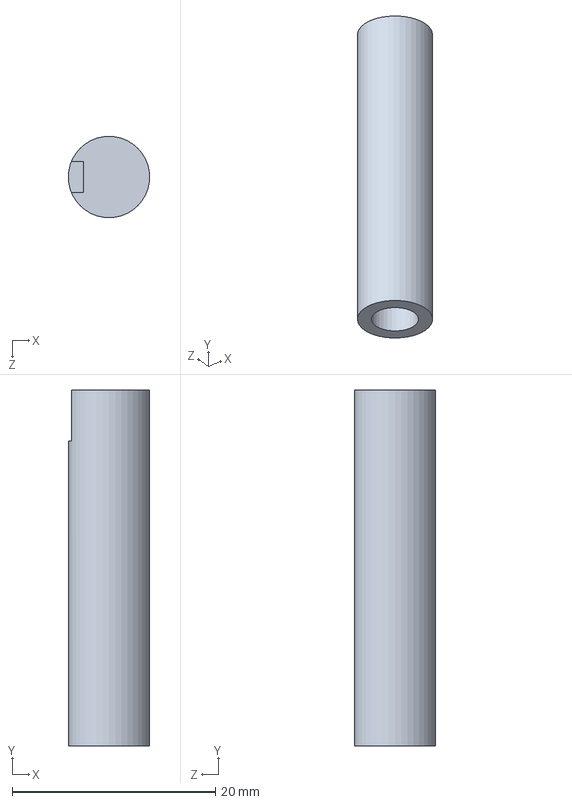
[picture p67: CAD file, 2026-07-01]
Joint 5-6/joint5MotorShaft.SLDPRT
8.00 x 35.0 x 8.00 mm
