quistty/6dofarm/Common parts/Gears/gear holder.SLDPRT

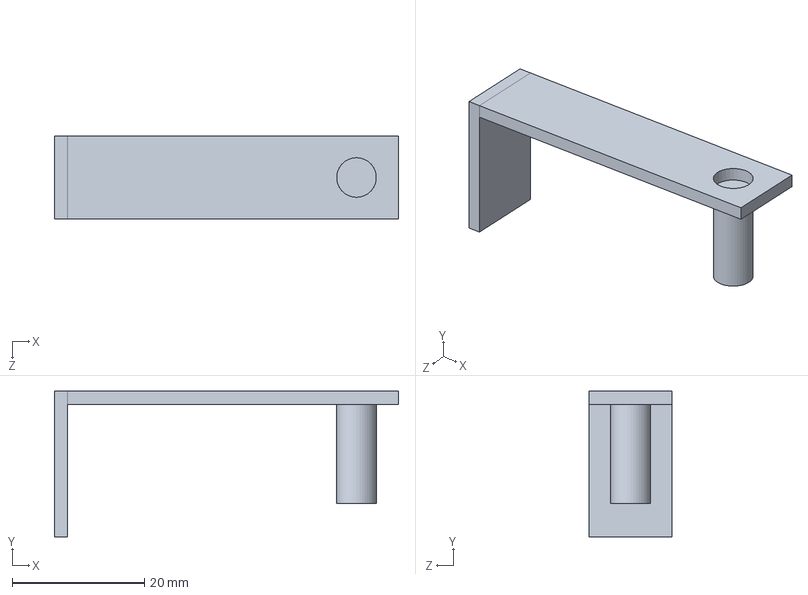
[picture p68: CAD file, 2026-06-26]
Common parts/Gears/gear holder.SLDPRT
52.0 x 22.0 x 12.5 mm
