quistty/6dofarm/Final Copy/Joint 1/J1_Bearing_Holder.SLDPRT

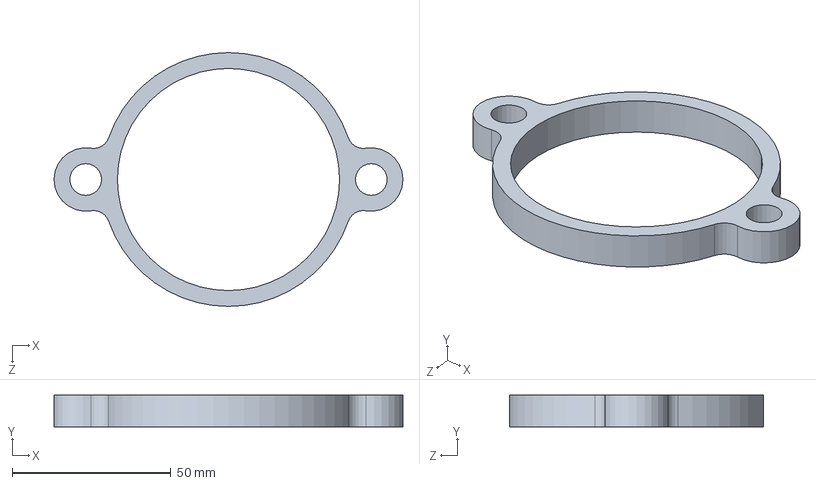
[picture p69: CAD file, 2026-08-21]
Final Copy/Joint 1/J1_Bearing_Holder.SLDPRT
110.0 x 10.0 x 80.0 mm
