quistty/6dofarm/Final Copy/Joint 3/J3_helicalHousingPin.SLDPRT

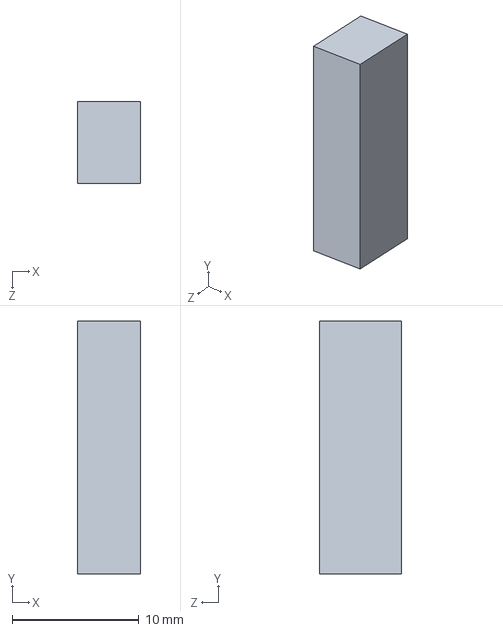
[picture p70: CAD file, 2026-07-13]
Final Copy/Joint 3/J3_helicalHousingPin.SLDPRT
5.00 x 20.0 x 6.50 mm
