quistty/6dofarm/Joint 5-6/gearTopCover.SLDPRT

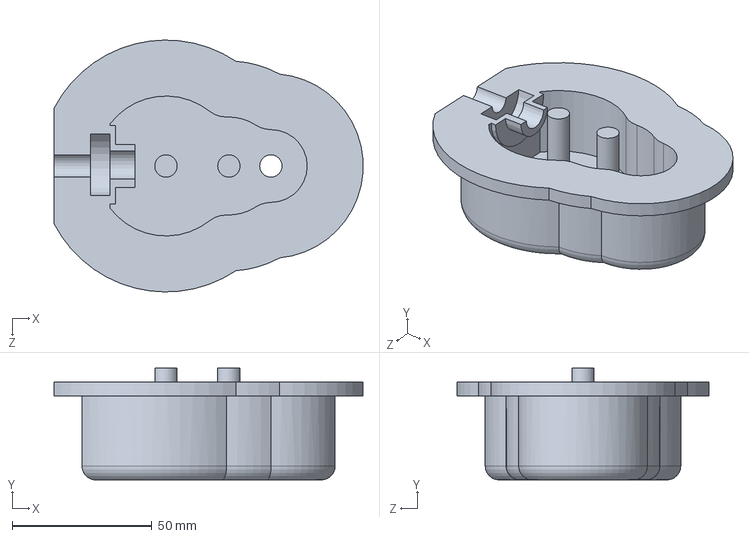
[picture p71: CAD file, 2026-07-01]
Joint 5-6/gearTopCover.SLDPRT
110.4 x 40.0 x 90.0 mm
