quistty/6dofarm/Final Copy/Joint 1/J1_helicalPlanet.SLDPRT

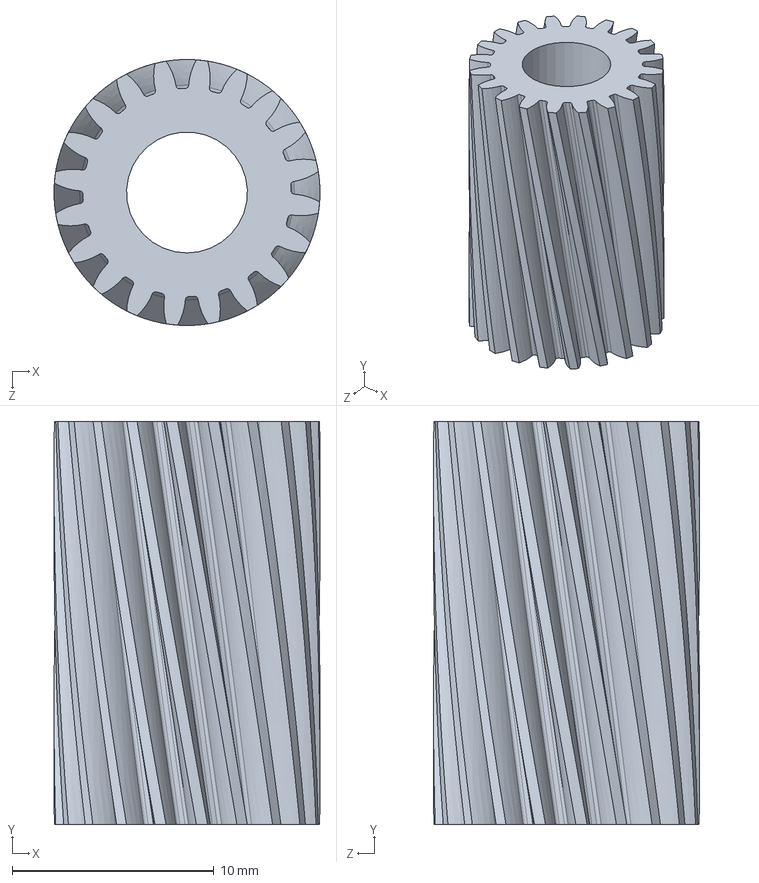
[picture p72: CAD file, 2026-08-21]
Final Copy/Joint 1/J1_helicalPlanet.SLDPRT
13.2 x 20.0 x 13.2 mm
