quistty/6dofarm/Joint 3/helicalHousing.SLDPRT

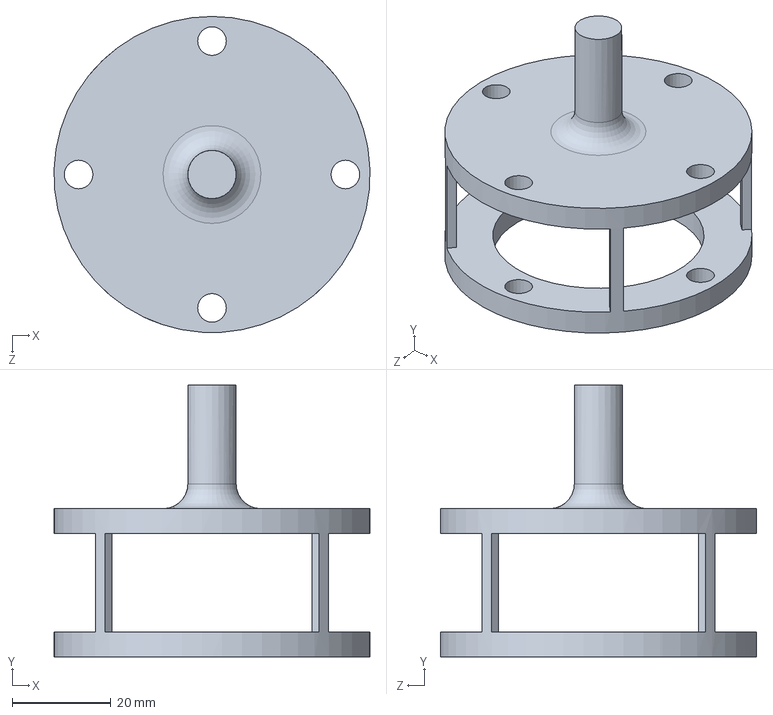
[picture p73: CAD file, 2026-07-13]
Joint 3/helicalHousing.SLDPRT
64.0 x 55.0 x 64.0 mm
