quistty/6dofarm/Joint 5-6/joint4Shaft.SLDPRT

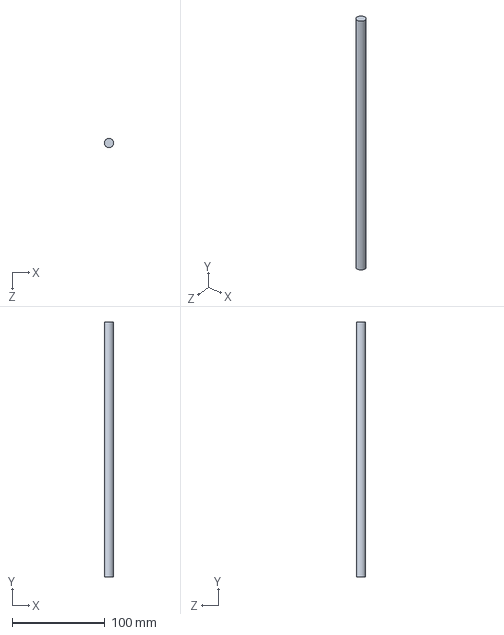
[picture p74: CAD file, 2026-06-26]
Joint 5-6/joint4Shaft.SLDPRT
9.99 x 275.0 x 10.0 mm
