quistty/6dofarm/Final Copy/Joint 3/J3_SecondHelicalSun.SLDPRT

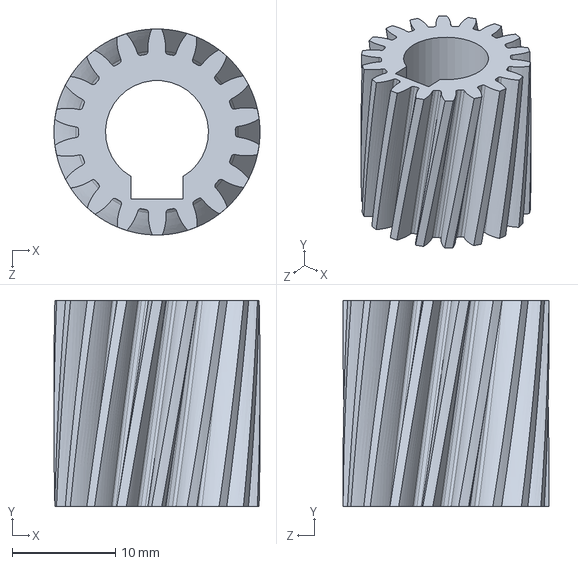
[picture p75: CAD file, 2026-07-13]
Final Copy/Joint 3/J3_SecondHelicalSun.SLDPRT
20.0 x 20.0 x 20.0 mm
