quistty/6dofarm/Prototypes/gear1.3MF

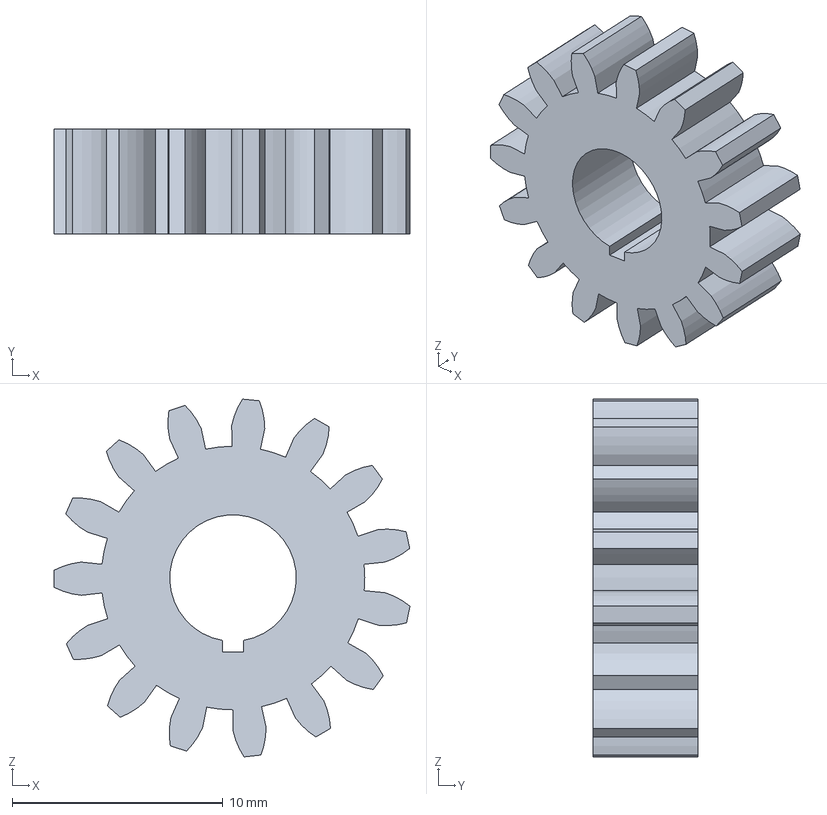
[picture p76: CAD file, 2026-06-26]
Prototypes/gear1.3MF
16.9 x 5.00 x 17.0 mm
