quistty/6dofarm/Joint 5-6/joint4BracketConnector.SLDPRT

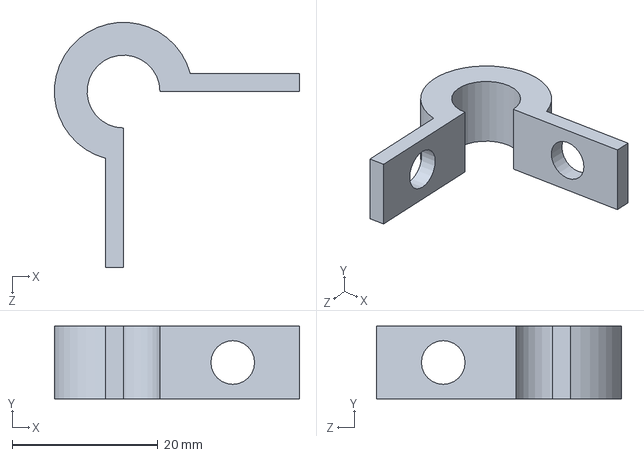
[picture p77: CAD file, 2026-06-25]
Joint 5-6/joint4BracketConnector.SLDPRT
33.6 x 10.0 x 33.6 mm
