quistty/6dofarm/Joint 5-6/nema 17 (DONT USE).SLDPRT

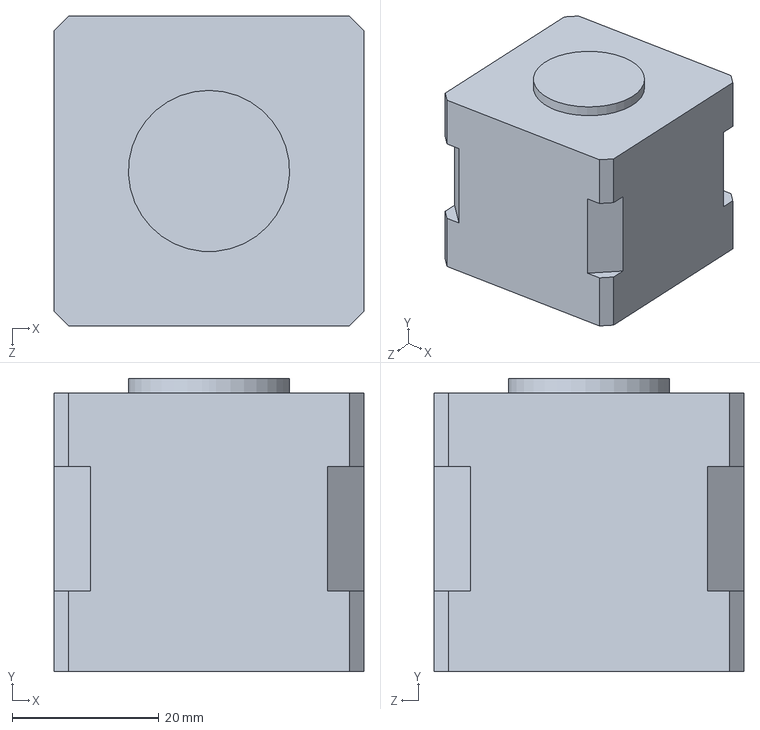
[picture p78: CAD file, 2026-06-25]
Joint 5-6/nema 17 (DONT USE).SLDPRT
42.3 x 40.0 x 42.3 mm
