quistty/6dofarm/Joint 5-6/joint4Bracket.SLDPRT

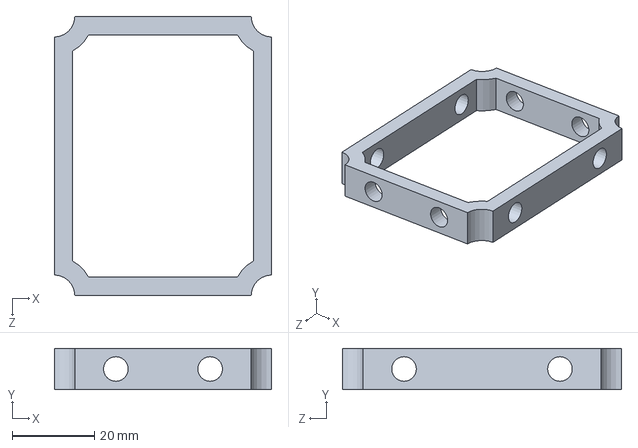
[picture p79: CAD file, 2026-06-25]
Joint 5-6/joint4Bracket.SLDPRT
53.0 x 10.0 x 68.0 mm
