quistty/6dofarm/Joint 5-6/joint5and6Base.SLDPRT

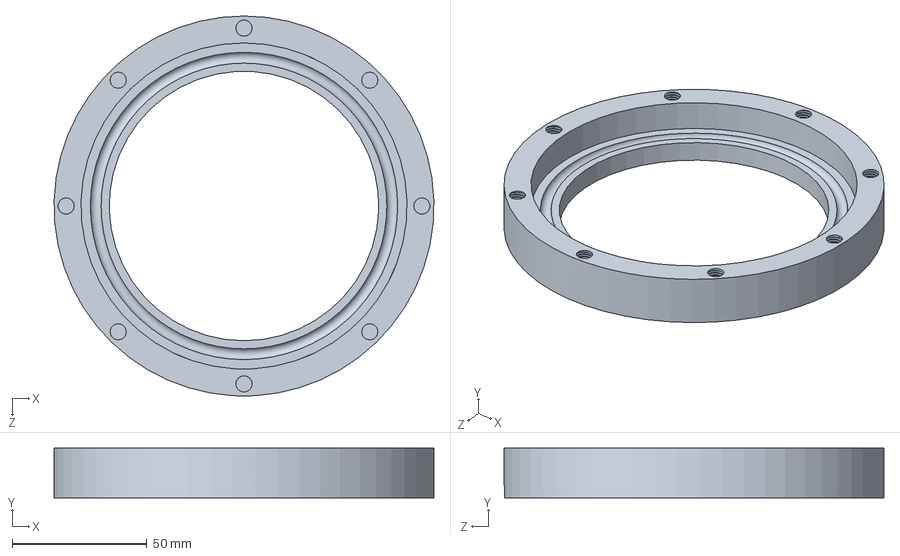
[picture p80: CAD file, 2026-06-17]
Joint 5-6/joint5and6Base.SLDPRT
140.9 x 18.5 x 141.0 mm
