quistty/6dofarm/Joint 5-6/joint5and6Head.SLDPRT

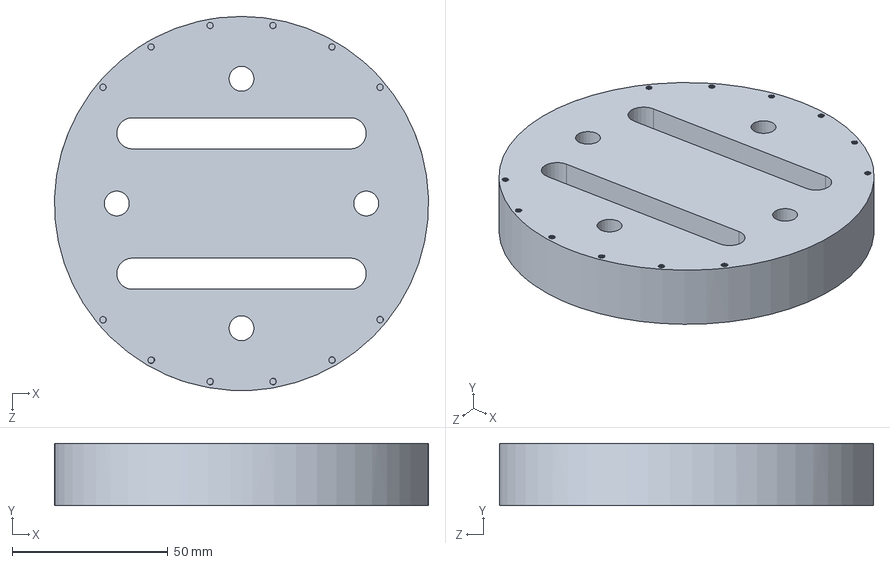
[picture p81: CAD file, 2026-06-14]
Joint 5-6/joint5and6Head.SLDPRT
119.9 x 20.0 x 120.0 mm
