quistty/6dofarm/Joint 5-6/joint5and6Cover.SLDPRT

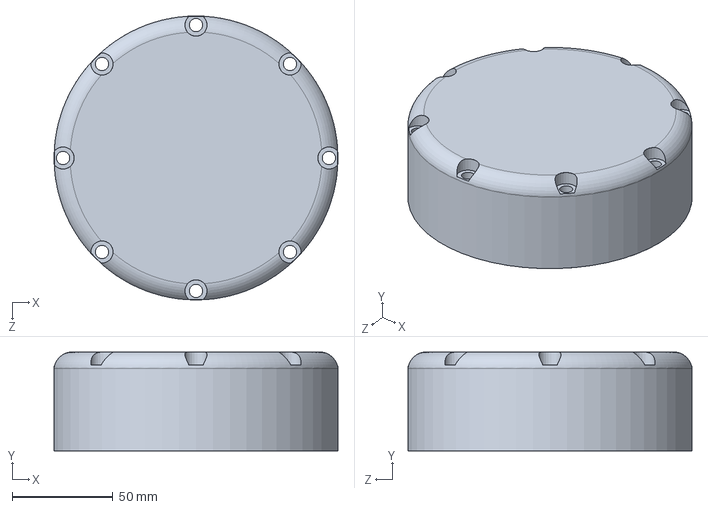
[picture p82: CAD file, 2026-06-14]
Joint 5-6/joint5and6Cover.SLDPRT
141.0 x 49.0 x 141.0 mm
