quistty/6dofarm/Final Copy/Joint 1/Joint 1 Assembly.SLDASM

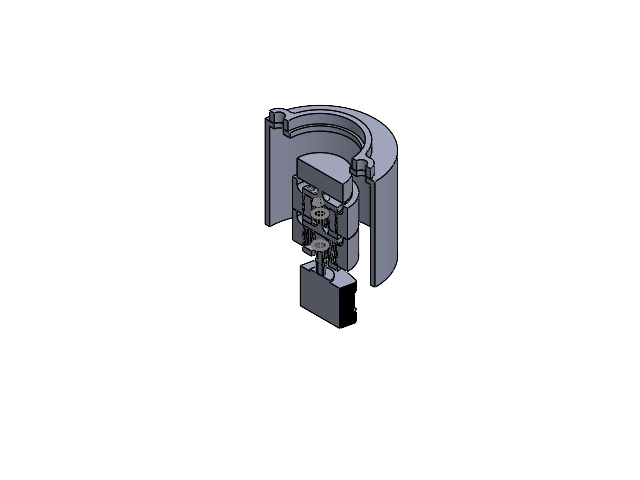
[picture p83: CAD file, 2026-08-21]
Final Copy/Joint 1/Joint 1 Assembly.SLDASM
J1_Motor_Housing
J1_helicalHousing x 2
J1_helicalPlanet x 8
J1_helicalSun
J1_helicalRing
J1_SecondHelicalSun
J1_helicalHousingPin
J1_Bearing_Holder
nema17Base
nema17Shaft
J1_Bottom_Housing
