quistty/6dofarm/Final Copy/Joint 3/J3_planetaryGearbox.SLDASM

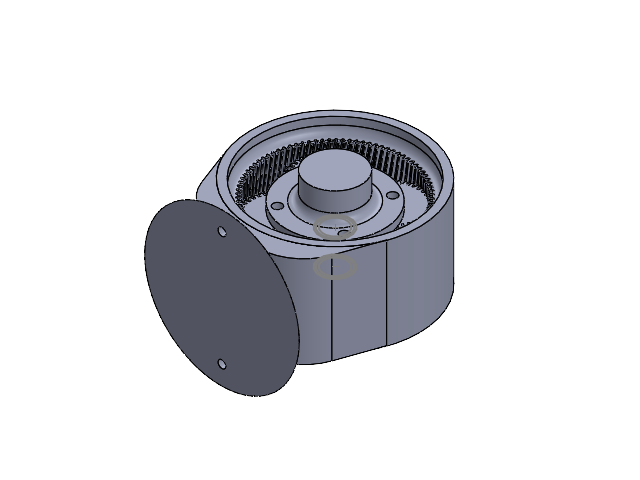
[picture p84: CAD file, 2026-08-21]
Final Copy/Joint 3/J3_planetaryGearbox.SLDASM
J3_helicalHousing x 2
J3_helicalPlanet x 8
J3_helicalSun
J3_helicalRing
J3_SecondHelicalSun
J3_helicalHousingPin
