quistty/6dofarm/Final Copy/Joint 5 and 6/Joint 5 and 6 assembly.SLDASM

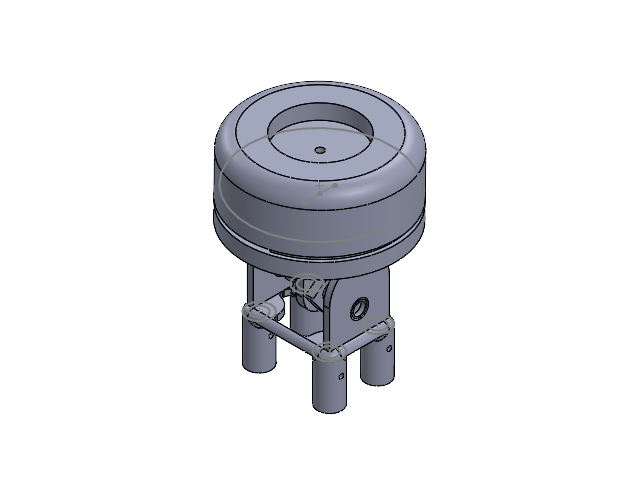
[picture p85: CAD file, 2026-08-21]
Final Copy/Joint 5 and 6/Joint 5 and 6 assembly.SLDASM
J5-6_Flange_Holder
J5-6_Bottom_Flange_Inner_Belt_Holder x 2
J5-6_Bottom_Flange
J5-6_Top_Flange
J5-6_Dowel_Holder x 2
