quistty/6dofarm/Final Copy/Main Assembly.SLDASM

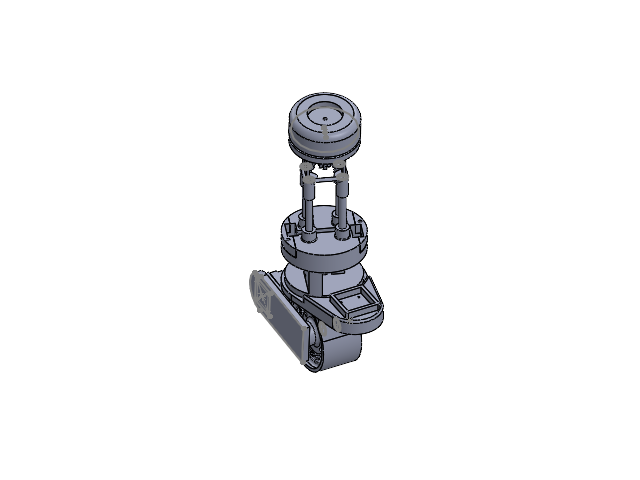
[picture p86: CAD file, 2026-08-13]
Final Copy/Main Assembly.SLDASM
J5-6_Flange_Holder
J5-6_Bottom_Flange_Inner_Belt_Holder x 2
J5-6_Bottom_Flange
J5-6_Top_Flange
J5-6_Dowel_Holder x 2
J4_Bottom_Motor_Housing
J4_Top_Motor_Housing
J4_Top_Motor_Housing_Bracket
J4_Connnecting_Rod x 4
J3_Motor_Holder
J3_helicalHousing x 2
J3_helicalPlanet x 8
J3_helicalSun
J3_helicalRing
J3_SecondHelicalSun
J3_helicalHousingPin
nema17Base
nema17Shaft
J3_Motor_Shaft
J3_Bearing_Bracket
