quistty/6dofarm/Joint 2/PlanetaryGearboxJoint2.SLDASM

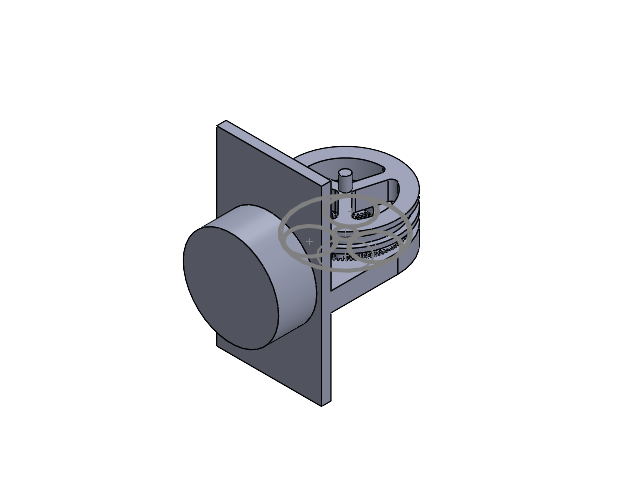
[picture p87: CAD file, 2026-08-21]
Joint 2/PlanetaryGearboxJoint2.SLDASM
GearRing
SunGear
PlanetGear x 3
HousingHelical
