quistty/6dofarm/Joint 3/planetaryGearbox.SLDASM

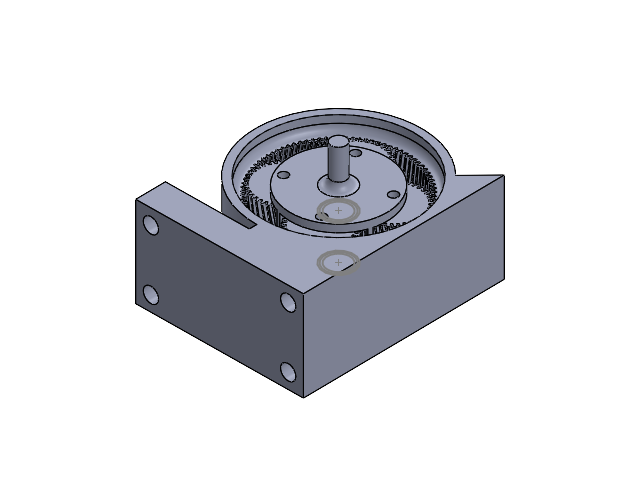
[picture p88: CAD file, 2026-08-13]
Joint 3/planetaryGearbox.SLDASM
helicalHousing x 2
helicalPlanet x 8
helicalSun
helicalRing
SecondHelicalSun
helicalHousingPin
