quistty/6dofarm/Rough Assembly Parts/assembly 1.SLDASM

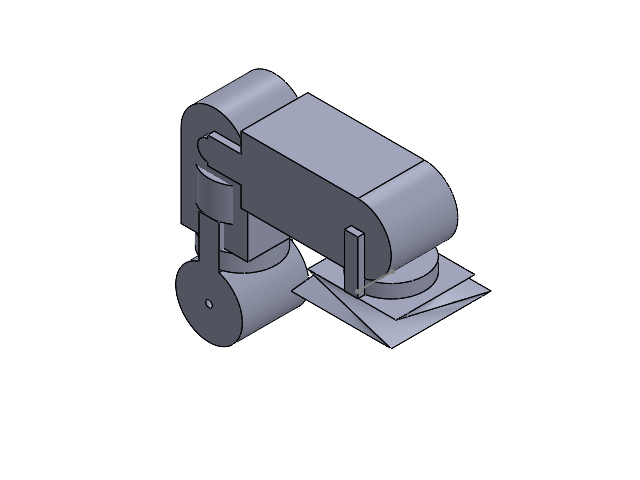
[picture p89: CAD file, 2026-06-14]
Rough Assembly Parts/assembly 1.SLDASM
j2
j3
j4
j5
j6
J1
