quistty/6dofarm/Final Copy/Joint 2/J2_PlanetaryGearboxJoint2.SLDASM

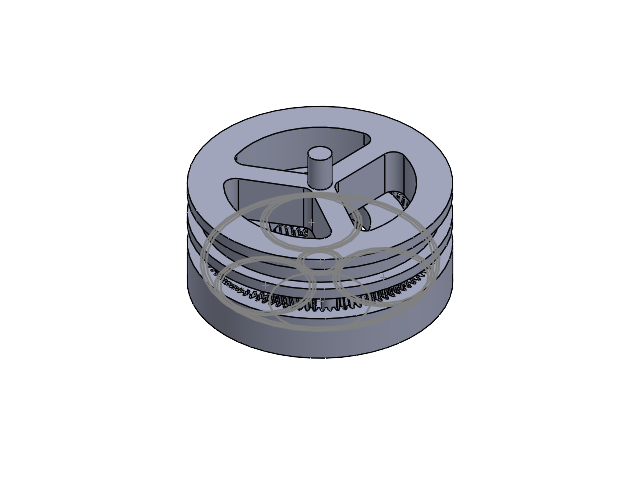
[picture p90: CAD file, 2026-08-21]
Final Copy/Joint 2/J2_PlanetaryGearboxJoint2.SLDASM
J2_GearRing
J2_SunGear
J2_PlanetGear x 3
J2_HousingHelical
