quistty/6dofarm/Final Copy/Joint 3/Joint 3 Assembly.SLDASM

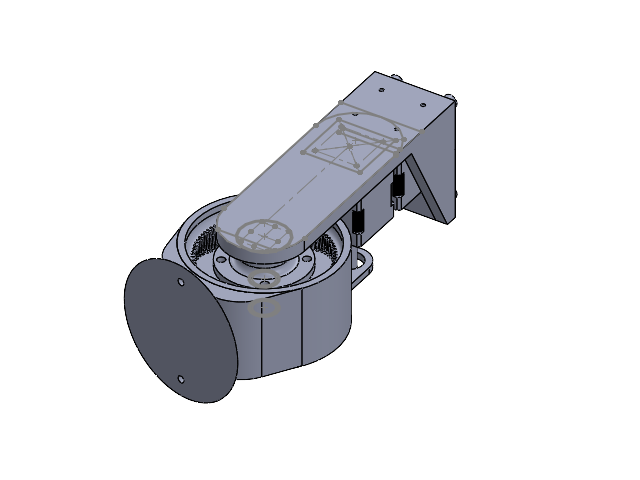
[picture p91: CAD file, 2026-08-21]
Final Copy/Joint 3/Joint 3 Assembly.SLDASM
J3_Motor_Holder
J3_helicalHousing x 2
J3_helicalPlanet x 8
J3_helicalSun
J3_helicalRing
J3_SecondHelicalSun
J3_helicalHousingPin
nema17Base x 2
nema17Shaft x 2
J3_Motor_Shaft
J3_Bearing_Bracket
