quistty/6dofarm/Joint 5-6/gearDiff.SLDASM

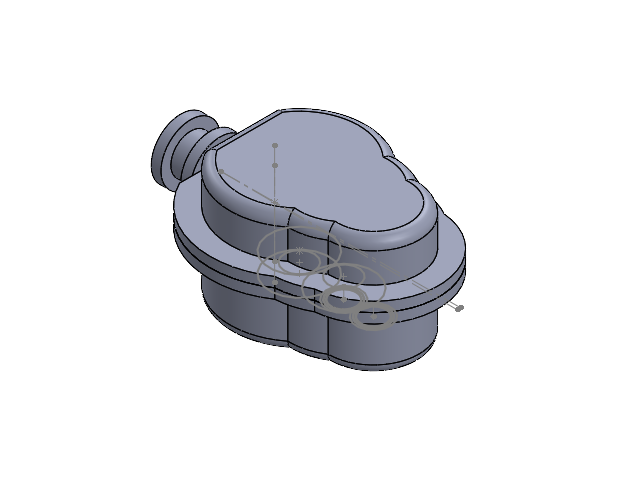
[picture p92: CAD file, 2026-07-15]
Joint 5-6/gearDiff.SLDASM
gearTopCover
Gear1 x 2
joint5BevelShaft
bevelGearLock
gearBottomCover
Spiral Bevel gear Z1
