quistty/6dofarm/Prototypes/gearAssemblyPrototype.SLDASM

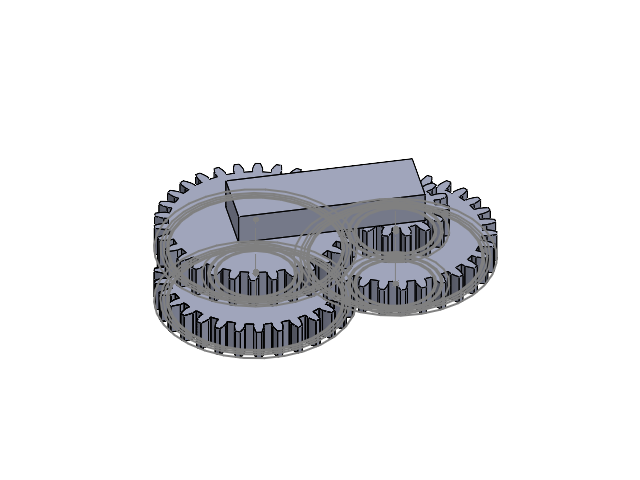
[picture p93: CAD file, 2026-07-15]
Prototypes/gearAssemblyPrototype.SLDASM
Gear1 x 3
Gear2 x 3
gearTEster
