quistty/6dofarm/Final Copy/Joint 1/J1_planetaryGearbox.SLDASM

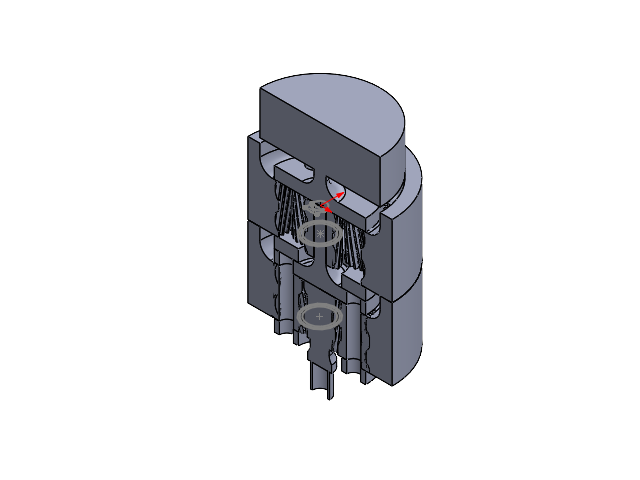
[picture p94: CAD file, 2026-08-21]
Final Copy/Joint 1/J1_planetaryGearbox.SLDASM
J1_helicalHousing x 2
J1_helicalPlanet x 8
J1_helicalSun
J1_helicalRing
J1_SecondHelicalSun
J1_helicalHousingPin
