quistty/6dofarm/Final Copy/Joint 2/Joint 2 Assembly.SLDASM

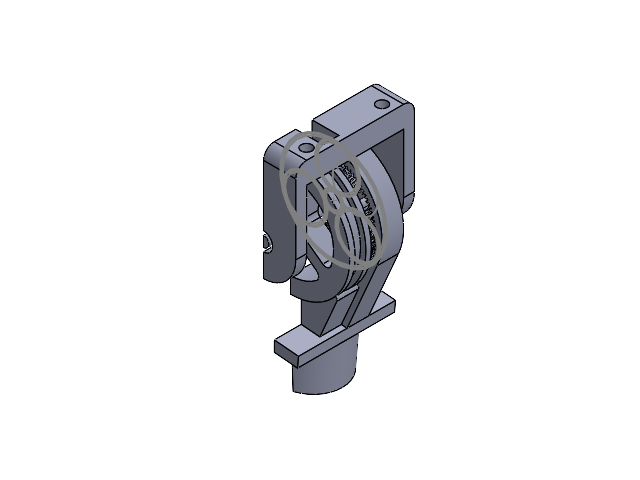
[picture p95: CAD file, 2026-08-21]
Final Copy/Joint 2/Joint 2 Assembly.SLDASM
Joint2RodHolder
J2_GearRing
J2_SunGear
J2_PlanetGear x 3
J2_HousingHelical
