quistty/6dofarm/Joint 5-6/joint5and6Assembly.SLDASM

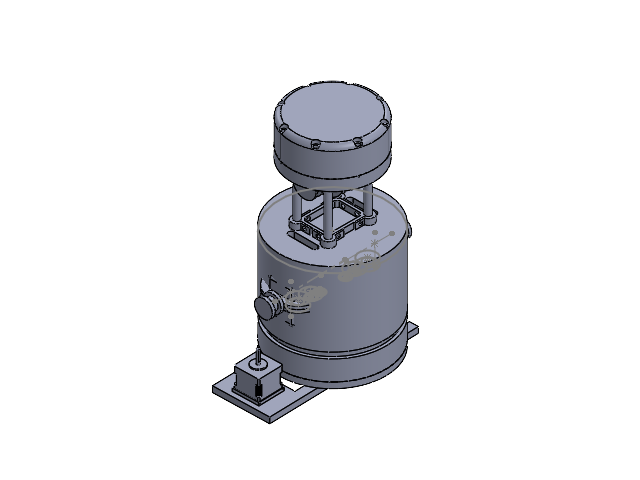
[picture p96: CAD file, 2026-07-14]
Joint 5-6/joint5and6Assembly.SLDASM
joint5and6MainBody
joint5and6Head
joint5and6Cover
joint5and6Base
joint4Shaft x 4
joint4Bracket
joint4BracketConnector x 4
joint4BracketBase
nema17Base x 3
nema17Shaft x 3
joint5MotorShaft x 2
gearTopCover x 2
Gear1 x 4
joint5BevelShaft x 2
bevelGearLock x 2
gearBottomCover x 2
Spiral Bevel gear Z1 x 2
joint5and6BottomCover
