quistty/6dofarm/Common parts/Gears/Bevel gear.SLDASM

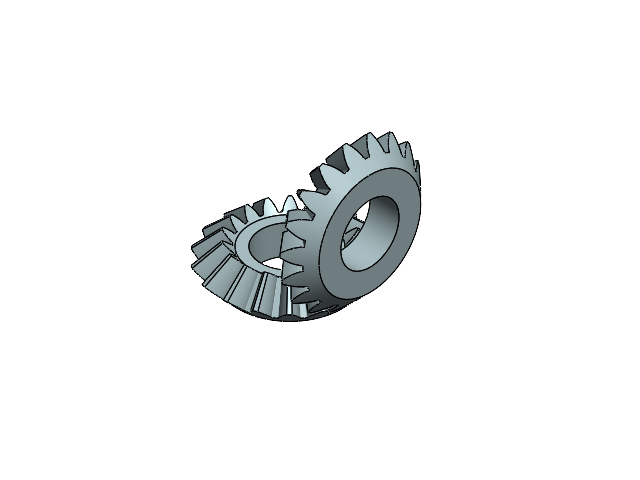
[picture p97: CAD file, 2026-07-01]
Common parts/Gears/Bevel gear.SLDASM
Spiral Bevel gear Z1 x 2
