quistty/6dofarm/(list of files, cad)

Other CAD files:
Common parts/Gears/spurBevelGear.SLDASM
Common parts/helicalGearCreator.SLDPRT
Joint 3/helicalSun.SLDPRT
Common parts/failed modeled bevel gear.SLDPRT
Final Copy/Joint 1/J1_Housing.SLDPRT
Common parts/Gears/Part2.SLDPRT
Prototypes/firstTimeBambuLabPrinting.3mf
Common parts/Gears/Gear2.SLDPRT
Prototypes/Part4.SLDPRT
Joint 3/helicalSun3.3mf
Prototypes/Part2.SLDPRT
Final Copy/Joint 3/J3_helicalPlanet.SLDPRT
Prototypes/gear2.3MF
Final Copy/Joint 1/J1_SecondHelicalSun.SLDPRT
Joint 3/helicalHousing.3mf
Joint 3/helicalSun.3MF
Joint 3/planetaryGearbox.3MF
Prototypes/Tolerances/40mm nominal shaft.3MF
Prototypes/Tolerances/40mm tolerance hole.3MF
Prototypes/gearAssemblyPrototype.3MF
Prototypes/gearTester.3MF
