quistty/6dofarm/(commit log)

2026-06-13 Assembly 1 Rough Sketch
    Allows us to visualize the constraints we will use in this project. constraints picked out look good and we can lock in actual lengths from this. since we are using simple materials we do not need to pick out lengths or do any calculations from this and can pick anything arbitrary for now based on what we want to be able to do
    [J1.SLDPRT, assembly 1.SLDASM, j2.SLDPRT, j3.SLDPRT, j4.SLDPRT, j5.SLDPRT, j6.SLDPRT]
2026-06-14 joint 5 and 6
    added main body + head for the main body.
    [assembly 1.SLDASM, joint5and6Assembly.SLDASM, joint5and6Head.SLDPRT, joint5and6MainBody.SLDPRT]
2026-06-14 Joint 5 and 6 mainly done
    added bearing track
    [joint5and6Assembly.SLDASM, joint5and6Base.SLDPRT, joint5and6Cover.SLDPRT, joint5and6Head.SLDPRT, joint5and6MainBody.SLDPRT]
2026-06-17 Update Joint 5-6 assembly and base part
    Update binary SolidWorks files for Joint 5-6: joint5and6Assembly.SLDASM and joint5and6Base.SLDPRT. These files were re-saved to capture recent design revisions to the assembly and its base part.
    [joint5and6Assembly.SLDASM, joint5and6Base.SLDPRT]
2026-06-25 Joint 5 and 6 housing completed
    Forgot to update recently but joint 5/6 housing has been created and we are creating gears now for the housing
    [gearCreator.SLDPRT, joint4Bracket.SLDPRT, joint4BracketBase.SLDPRT, joint4BracketConnector.SLDPRT, joint4Shaft.SLDPRT, joint5MotorShaft.SLDPRT, joint5and6Assembly.SLDASM, joint5and6MainBody.SLDPRT]
2026-06-25 i hate gears
    i hate gears
    [Gear1.SLDPRT, Gear2.SLDPRT, gear3.SLDPRT, gearCreator.SLDPRT, gearKey.SLDPRT, joint4BracketBase.SLDPRT, joint5MotorShaft.SLDPRT, joint5and6Assembly.SLDASM]
2026-06-26 Add prototypes and update gears/joints
    Add multiple prototype parts and 3MF prints under Prototypes (Part2/Part4/Part5, combinedGears, gear1/gear2, gearAssemblyPrototype.*, gearTEster.SLDPRT, gearTester.3MF). Add new gear holder in Common parts. Update existing CAD assemblies/parts: Common parts/Gears/Gear2.SLDPRT, Common parts/nema17.SLDASM, Joint 5-6/joint4Shaft.SLDPRT and Joint 5-6/joint5and6Assembly.SLDASM. Remove SolidWorks temporary files (~$* ) from Joint 5-6 and relocate several temp files into the Prototypes folder to clean up workspace.
    [Gear2.SLDPRT, Part2.SLDPRT, Part4.SLDPRT, Part5.SLDPRT, combinedGears.3MF, gear holder.SLDPRT, gear1.3MF, gear2.3MF]
2026-06-29 Add first-time Bambu print and update prototypes
    Add new firstTimeBambuLabPrinting.3mf and update prototype model files: Prototypes/combinedGears.3MF, Prototypes/gearTester.3MF, and Prototypes/gearTEster.SLDPRT. These are binary 3D model/CAD updates for the gear prototypes and include a new file intended for initial Bambu Lab printing.
    [combinedGears.3MF, firstTimeBambuLabPrinting.3mf, gearTEster.SLDPRT, gearTester.3MF]
2026-06-30 Add SolidWorks bevel gear part
    Add the SolidWorks part file 'Common parts/failed modeled bevel gear.SLDPRT'. The commit also includes an auto-generated temporary file 'Common parts/~$failed modeled bevel gear.SLDPRT' which appears to be a transient lock/temp file; consider removing it and adding SolidWorks temp patterns to .gitignore to avoid committing such files in the future.
    [failed modeled bevel gear.SLDPRT]
2026-07-01 Add bevel gears and Joint 5-6 parts
    Add new bevel/spur gear CAD files and Joint 5-6 components and update related parts. New files include Common parts/Gears (Bevel gear.SLDASM, Part2, gearLocker, spurBevelGear.SLDASM, updated Gear1 and gear3), Joint 5-6 parts and assemblies (bevelGearLock, gearBottomCover, gearDiff.SLDASM, gearTopCover, joint5BevelShaft and others) and a Spiral Bevel gear prototype (.3mf). Also update joint5MotorShaft.SLDPRT, joint5and6Assembly.SLDASM and Prototypes/Part5.SLDPRT. Many SolidWorks temporary autosave files (~$...) were added/renamed as well; consider cleaning them up if unintended.
    [Bevel gear.SLDASM, Gear1.SLDPRT, Part2.SLDPRT, Part5.SLDPRT, Spiral Bevel gear Z1.3mf, bevelGearLock.SLDPRT, gear3.SLDPRT, gearBottomCover.SLDPRT]
2026-07-03 Update nema17 and joint 5-6 assembly components
    - Modified nema17Base stepper motor base component
    - Updated joint4BracketBase and joint5and6Assembly designs
    - Added new joint5and6BottomCover part
    - Renamed temporary gear locker file
    [joint4BracketBase.SLDPRT, joint5and6Assembly.SLDASM, joint5and6BottomCover.SLDPRT, nema17Base.SLDPRT]
2026-07-13 Add helical gear components and clean up temp files
    Add new helical gear planetary gearbox assembly to Joint 3, including sun, planet, ring, housing, and pin components. Update existing gear and nema17 assemblies. Remove SolidWorks temporary lock files (~$) across all folders. Add helicalGearCreator part to Common parts.
    [Part5.SLDPRT, SecondHelicalSun.SLDPRT, gearAssemblyPrototype.SLDASM, gearBottomCover.SLDPRT, gearDiff.SLDASM, helicalGearCreator.SLDPRT, helicalHousing.3mf, helicalHousing.SLDPRT]
2026-07-14 Add SOLIDWORKS temporary lock files
    These are temporary files generated by SOLIDWORKS when opening design files. They should be added to .gitignore instead of being committed to the repository.
    [gearDiff.SLDASM, joint5and6Assembly.SLDASM, planetaryGearbox.SLDASM, spurBevelGear.SLDASM]
2026-07-15 Add helical & planetary gear parts
    Adds numerous SolidWorks parts and assemblies for gears and joints: helicalGearCreator, sun/planet/gearring parts for Joint 2 and Joint 3, helical housing, planetary gearbox assemblies, and Joint 5-6 gear components. Updates several existing assemblies (nema17, helicalRing, planetaryGearbox, gearDiff, joint5and6Assembly, gearAssemblyPrototype). Note: several SolidWorks temporary/lock files (~$...) were also added.
    [GearRing.SLDPRT, HousingHelical.SLDPRT, Joint2RodHolder.SLDPRT, Joint2Rods.SLDPRT, PlanetGear.SLDPRT, PlanetaryGearboxJoint2.SLDASM, SunGear.SLDPRT, gearAssemblyPrototype.SLDASM]
2026-07-15 Update PlanetaryGearboxJoint2 assembly
    Modify Joint 2 planetary gearbox assembly file with design updates.
    [PlanetaryGearboxJoint2.SLDASM]
2026-07-15 Update assemblies and add Joint 1 components (FIRST COMPONET DONE)
    Updates to nema17 motor assembly, Joint 2 gearbox components, and Joint 5-6 assembly. Adds new BearingHolder and Joint1Housing parts for Joint 1. Note: Commit includes SolidWorks temporary lock files (~$ files) which should be added to .gitignore to prevent future accidental commits.
    [BearingHolder.SLDPRT, GearRing.SLDPRT, Joint1Housing.SLDPRT, PlanetaryGearboxJoint2.SLDASM, nema17.SLDASM]
2026-07-18 Add first rendition documentation for all robot joints
    Add comprehensive design review documents for Joints 1-6. Each document describes the first CAD rendition design overview, successful elements, identified problems, and requirements for the next iteration. These reviews cover the base rotation joint, shoulder joint, arm joint, wrist assembly joints, and differential pulley systems.
2026-08-05 Add Joint 5-6 bottom flange parts; remove temp SW files
    Adds finalized SolidWorks parts for Joint 5-6 (J5-6_Bottom_Flange.SLDPRT and J5-6_Bottom_Flange_Inner_Belt_Holder.SLDPRT) and Prototypes/Part1.SLDPRT. Removes many SolidWorks temporary/autosave files (names prefixed with "~$") across Common parts, Joint directories, and Prototypes. Also renames two temporary gear files into the Final Copy/Joint 5 and 6 paths. Cleanup and addition of finalized 3D assets.
    [J5-6_Bottom_Flange.SLDPRT, J5-6_Bottom_Flange_Inner_Belt_Holder.SLDPRT, Part1.SLDPRT]
2026-08-06 Add J5-6 top flange and update bottom components
    Add new J5-6 top flange part and update existing bottom flange and inner belt holder components. Removed temporary SOLIDWORKS lock files.
    [J5-6_Bottom_Flange.SLDPRT, J5-6_Bottom_Flange_Inner_Belt_Holder.SLDPRT, J5-6_Top_Flange.SLDPRT]
2026-08-07 added hole for magney
    [J5-6_Bottom_Flange_Inner_Belt_Holder.SLDPRT]
2026-08-08 Add Joint 5&6 SolidWorks parts and assembly
    Add SolidWorks files for Joint 5 and 6 under Final Copy/Joint 5 and 6: J5-6_Flange_Holder.SLDPRT and Joint 5 and 6 assembly.SLDASM. Also includes several SolidWorks temporary/lock files (~$...) that were added accidentally; recommend removing those and adding proper .gitignore entries for SolidWorks temp files.
    [J5-6_Flange_Holder.SLDPRT, Joint 5 and 6 assembly.SLDASM]
2026-08-08 Add main assembly; update Joint 5-6 parts
    Adds Main Assembly.SLDASM and the Joint 4 connecting rod part (plus their temporary ~$ files). Updates Joint 5 & 6 geometry and assembly: J5-6_Bottom_Flange.SLDPRT, J5-6_Flange_Holder.SLDPRT, J5-6_Top_Flange.SLDPRT, and Joint 5 and 6 assembly.SLDASM. All changes are binary SolidWorks documents.
    [J4_Connnecting_Rod.SLDPRT, J5-6_Bottom_Flange.SLDPRT, J5-6_Flange_Holder.SLDPRT, J5-6_Top_Flange.SLDPRT, Joint 5 and 6 assembly.SLDASM, Main Assembly.SLDASM]
2026-08-11 Add J4 motor housing and clean temp files
    Add new J4_Top_Motor_Housing component and update related assemblies. Remove Solidworks temporary lock files (~$ prefixed) from Joint 4, Joint 5-6, and main assembly directories. Update J5-6_Flange_Holder part and assemblies with latest revisions.
    [J4_Top_Motor_Housing.SLDPRT, J5-6_Flange_Holder.SLDPRT, Joint 5 and 6 assembly.SLDASM, Main Assembly.SLDASM]
2026-08-11 Add Joint 4 and Joint 5-6 SolidWorks files
    Add SolidWorks part and assembly files for Joint 4 and Joint 5-6. New files include J4_Bottom_Motor_Housing.SLDPRT, J4_Top_Motor_Housing_Bracket.SLDPRT, Joint 4 Assembly.SLDASM, and several temporary SolidWorks lock files (~$...). Updated binaries: J4_Top_Motor_Housing.SLDPRT, J5-6_Bottom_Flange_Inner_Belt_Holder.SLDPRT, and Joint 5 and 6 assembly.SLDASM. Note: repository now contains generated/lock (~$...) SolidWorks temporary files that may be removed or ignored via .gitignore.
    [J4_Bottom_Motor_Housing.SLDPRT, J4_Top_Motor_Housing.SLDPRT, J4_Top_Motor_Housing_Bracket.SLDPRT, J5-6_Bottom_Flange_Inner_Belt_Holder.SLDPRT, Joint 4 Assembly.SLDASM, Joint 5 and 6 assembly.SLDASM]
2026-08-12 Update SolidWorks assemblies; remove temp files
    Updated SolidWorks part and assembly files: Joint 4 (top/bottom motor housings and assembly), Joint 5 & 6 assembly, and Main Assembly. Removed SolidWorks temporary/lock autosave files (~$... entries). Changes are binary SolidWorks file updates and cleanup of temporary files.
    [J4_Bottom_Motor_Housing.SLDPRT, J4_Top_Motor_Housing.SLDPRT, Joint 4 Assembly.SLDASM, Joint 5 and 6 assembly.SLDASM, Main Assembly.SLDASM]
2026-08-13 EVerything BEFORE joint 3!!!
    This is the first half of the robot actually completed!
    [J5-6_Bottom_Flange.SLDPRT, J5-6_Dowel_Holder.SLDPRT, J5-6_Top_Flange.SLDPRT, Joint 4 Assembly.SLDASM, Joint 5 and 6 assembly.SLDASM, Main Assembly.SLDASM, planetaryGearbox.SLDASM]
2026-08-13 Joint 3 Completed!
    [J3_Bearing_Bracket.SLDPRT, J3_Motor_Holder.SLDPRT, J3_Motor_Shaft.SLDPRT, J3_Motor_Shaft_Key.SLDPRT, J3_SecondHelicalSun.SLDPRT, J3_helicalHousing.SLDPRT, J3_helicalHousingPin.SLDPRT, J3_helicalPlanet.SLDPRT]
2026-08-18 Remove SolidWorks temp files; add tolerance prototypes
    Clean up SolidWorks temporary files (~$* entries) across multiple folders and update binary assemblies. Update Common parts/nema17.SLDASM and Joint 5-6/joint5and6Assembly.SLDASM. Add Prototypes/Tolerances fixtures: "40mm nominal shaft" (.3MF, .SLDPRT) and "40mm tolerance hole" (.3MF, .SLDPRT). The change removes transient editor files and adds prototype tolerance parts for testing/manufacturing.
    [40mm nominal shaft.3MF, 40mm nominal shaft.SLDPRT, 40mm tolerance hole.3MF, 40mm tolerance hole.SLDPRT, nema17.SLDASM]
2026-08-21 Main components all completed!
    [BearingHolder.SLDPRT, J1_Bearing_Holder.SLDPRT, J1_Bottom_Housing.SLDPRT, J1_Housing.SLDPRT, J1_Motor_Housing.SLDPRT, J1_SecondHelicalSun.SLDPRT, J1_helicalHousing.SLDPRT, J1_helicalHousingPin.SLDPRT]
